carologistics/hardware/TMC2208/Solder_Pads.jpg

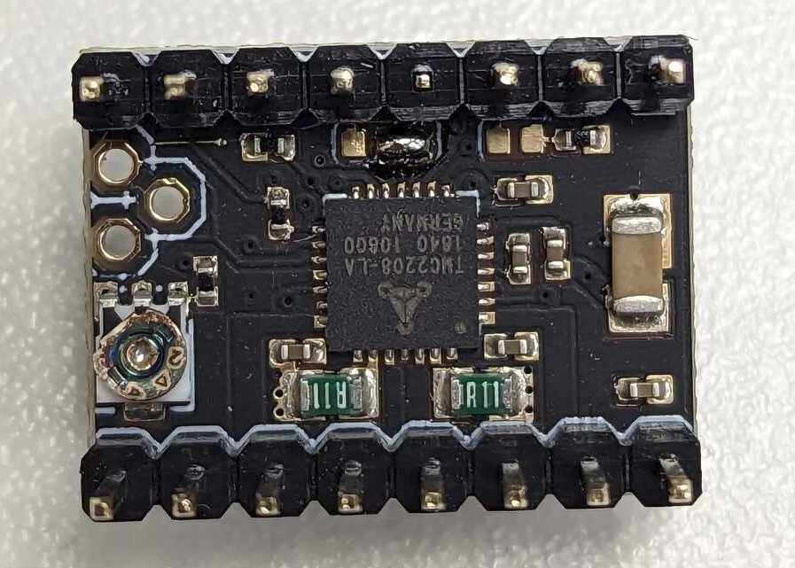
TMC2208/Solder_Pads.jpg
