carologistics/hardware/pictures/frontlaser_mount.jpg

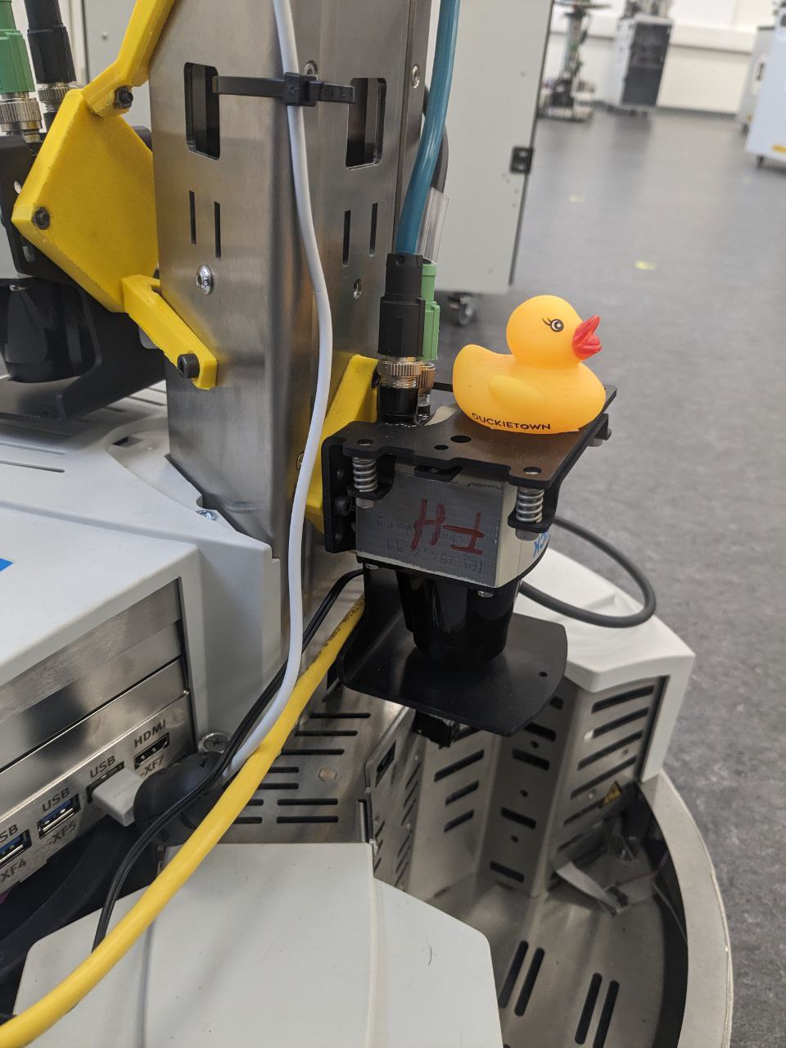
pictures/frontlaser_mount.jpg
