carologistics/hardware/gcode/README.md

# gcode folder

gcode files are needed to start a printjob on a 3d printer.
This folder, and all its subfolders, contain the  gcode files of all the current cad parts.

**NOTE:** Those gcode files are **only** suitable for the Prusa MK3S 3D printer in combination with PLA filament!

## How to start a printjob

1. Copy the gcode file on the printers SD card
2. Insert SD card back into printer
3. Choose file to print
   - If the files do not show up immediatly on the printer, press knob once and scroll down to `print from SD card`
4. Press knob once
5. The print is starting

### Multiple part prints

Some parts have two corresponding gcode files. For those parts, usually, multiple pieces are needed.

For instance, the realsense needs two 3d printed parts to be mounted. They can both be printed with one file.

```
blasterxmounting_x2_0.2mm_PLA_MK3S.gcode
```

However, sometimes only one part is needed. Those single parts can be printed with the file not containing the "x2".

```
blasterxmounting_0.2mm_PLA_MK3S.gcode
```

### Conductive parts

The `backfinger` and the `contact` need to be printed out of conductive PLA.
