carologistics/hardware/Notizen Akku Monitoring/Beschreibung Programm.docx

## Zweck

- Akkuzustand überwachen (Busspannung, Strom, Verbrauch)
- Restlaufzeit grob schätzen (über gemittelten Strom)
- Akkuslots prüfen (Temperatur, Plug in/out, Maschinen-ID)
- Alles nur auf Befehl starten und per Akku-Check abrufen

## Eingänge

### Messwerte

- Gesamtstrom I(t) vom ACS758-200B (A)
- Busspannung U_bus(t) vom Robotino (V)
- Pro Akkuslot:
  - plug_i (0/1) – Akku steckt?
  - temp_i (°C oder Rohwert) – Akkutemperatur
  - id_i (int/Rohwert) – Maschinen-ID

### Parameter (fix / Konfiguration)

- Ah_pack = Kapazität pro Akku (Ah) (alle gleich)
- sample_rate_hz (z. B. 5–10 Hz)
- avg_window_s (z. B. 60 s)
- U0_measure_time_s (z. B. 3 s)

## Ausgänge

### Laufende Statuswerte

- n_packs (Anzahl aktiver Akkus, aus Plug in/out)
- I_last (letzter Stromwert)
- I_avg (Durchschnitt über Zeitfenster)
- Ah_used (verbrauchte Ah seit Start)
- Ah_total = n_packs * Ah_pack
- Ah_rest = Ah_total - Ah_used
- t_rest (Restlaufzeit in h:min)

### Check-Report

- Alles oben + Slotdetails + Zeitstempel der letzten Messung

## Befehle (User Interface)

### 1) /Akku monitorer

Startet Monitoring.

Was passiert:

1. Slots scannen → n_packs bestimmen (aus Plug in/out)
2. Ah_total berechnen
3. U0 setzen:
  - Hinweis im Ablauf: U0 nur bei ruhigen Motorbewegungen
  - Mittelwert über z. B. 3 s
4. Zähler/Buffer zurücksetzen (Ah_used=0, Strompuffer leeren)
5. Monitoring-Loop starten

### 2) /Akku check

Gibt einen Snapshot aus:

- n_packs
- U_bus aktuell + U0 (falls vorhanden)
- I_last + Zeitstempel „letzte Messung“
- I_avg (aktueller Durchschnitt)
- Ah_used / Ah_total
- t_rest
- pro Slot: plug/temp/id

### 3) /Akku stop

Stoppt Monitoring und geht zurück zu Idle.

## Programmzustände

### State A: Idle

- wartet auf /Akku monitorer

### State B: Init

- Akkus erkennen
- U0 aufnehmen (ruhig)
- Variablen initialisieren

### State C: Monitoring

Loop in festem Intervall:

1. Strom messen
- I_last = read_ACS758()
2. Verbrauch integrieren (Coulomb Counting)

Ah_(used) +=I_(last) ⋅(Δt)/3600

3. Durchschnittsstrom aktualisieren
- Puffer mit letzten avg_window_s Sekunden
- I_avg = mean(buffer)
4. Restlaufzeit

t_(rest) =(Ah_(total) -Ah_(used))/(I_(avg))

(Edgecase: wenn I_avg sehr klein → Restlaufzeit als „sehr groß / nicht sinnvoll“)

5. Letzte Messung speichern
- Timestamp aktualisieren
- optional Logging

## Wichtige Hinweise im Programmtext

- U0 nur bei ruhigen Motorbewegungen verwenden, weil Spannung unter Last stark abweicht.
- Robotino liefert Busspannung, keine Einzelakku-Spannungen.
- ACS758 misst Gesamtstrom nach dem Akku-Bus (nicht interne Ausgleichsströme zwischen Akkus).

Akku-Monitoring System Beschreibung Programm
