carologistics/hardware/pictures/backlaser_mount.jpg

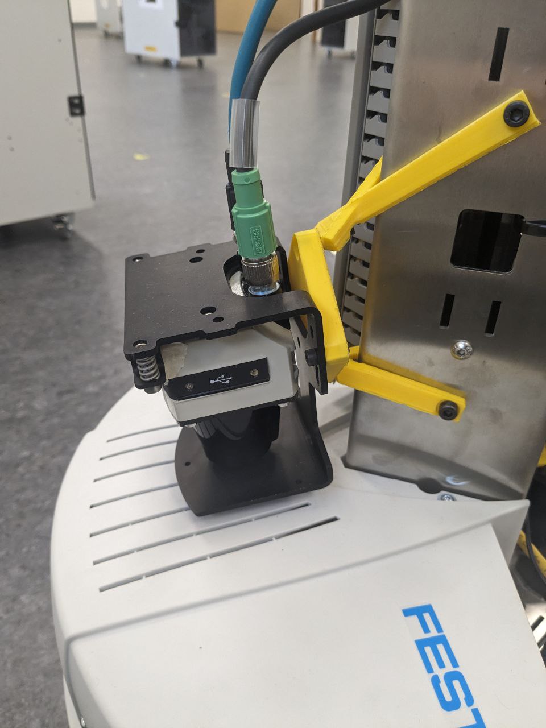
pictures/backlaser_mount.jpg
