carologistics/hardware/cad/realsense/assemblytool.SLDPRT

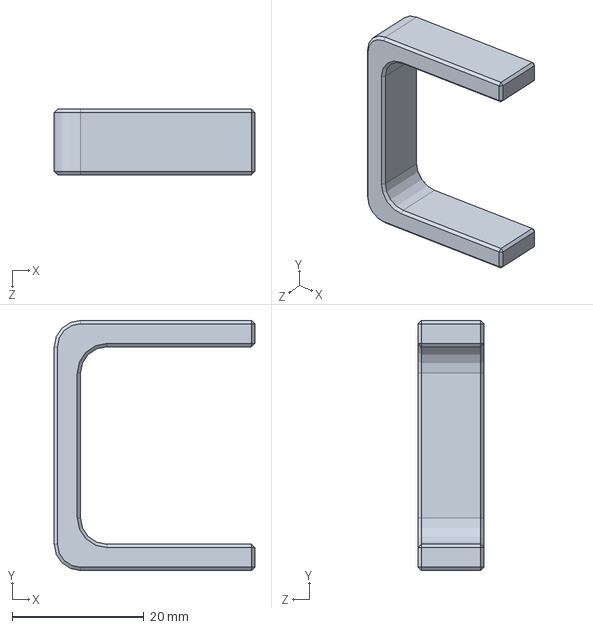
[picture p4: CAD file, 2019-02-01]
cad/realsense/assemblytool.SLDPRT
30.5 x 38.0 x 10.0 mm
