carologistics/hardware/cad/gripper/assembled_positioningdisk.SLDASM

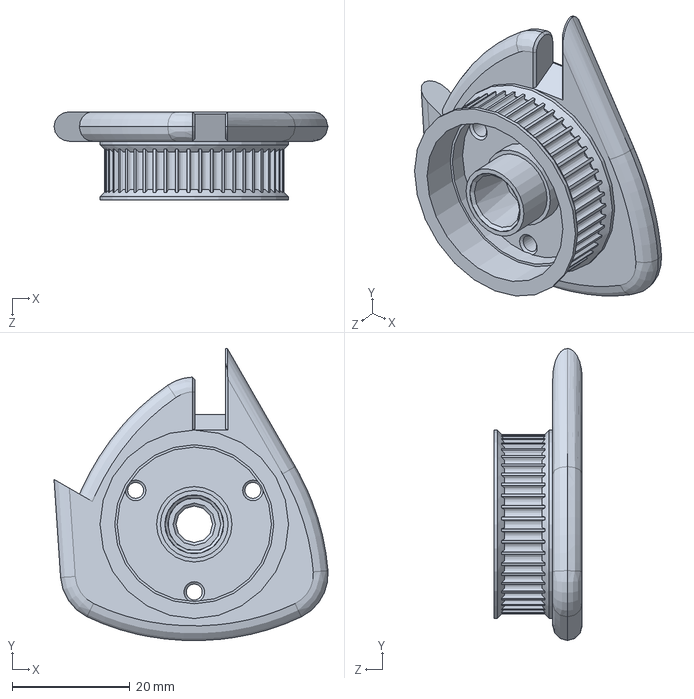
[picture p5: CAD file, 2024-03-26]
cad/gripper/assembled_positioningdisk.SLDASM
46.5 x 49.6 x 15.0 mm
