carologistics/hardware/cad/gripper/baseplatejoined.SLDASM

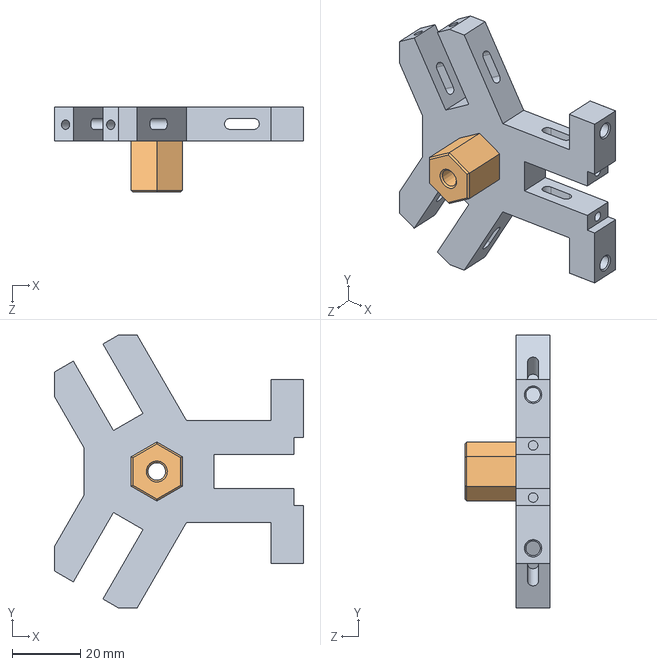
[picture p6: CAD file, 2024-03-26]
cad/gripper/baseplatejoined.SLDASM
73.0 x 80.0 x 25.0 mm
baseplate
middleconnector
