carologistics/hardware/cad/gripper/gripperassembly.SLDASM

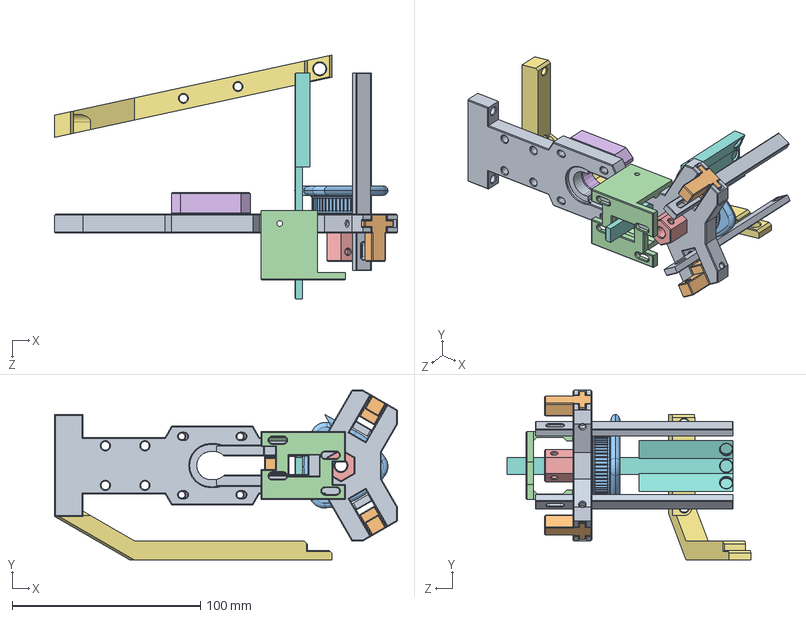
[picture p7: CAD file, 2019-10-24]
cad/gripper/gripperassembly.SLDASM
182.0 x 90.0 x 129.4 mm
baseplate
stopper x 3
positioningdisk
middleconnector
stepperflange
backfinger
frontfinger x 2
