carologistics/hardware/cad/axes/yaxismounting.SLDPRT

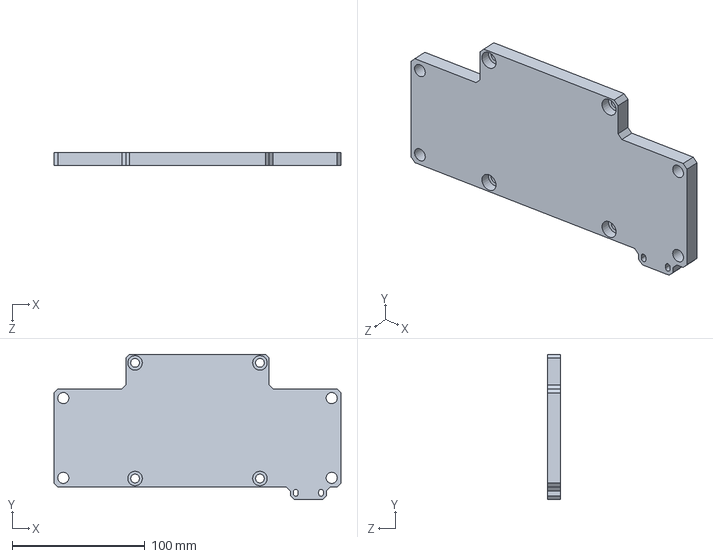
[picture p8: CAD file, 2024-03-26]
cad/axes/yaxismounting.SLDPRT
216.0 x 109.5 x 10.0 mm
