carologistics/hardware/cad/gripper/Gripper Version 2 (speziell deutsche Meisterschaft)/stl/01-01 Gripper_Basis_2 Servo System.stl

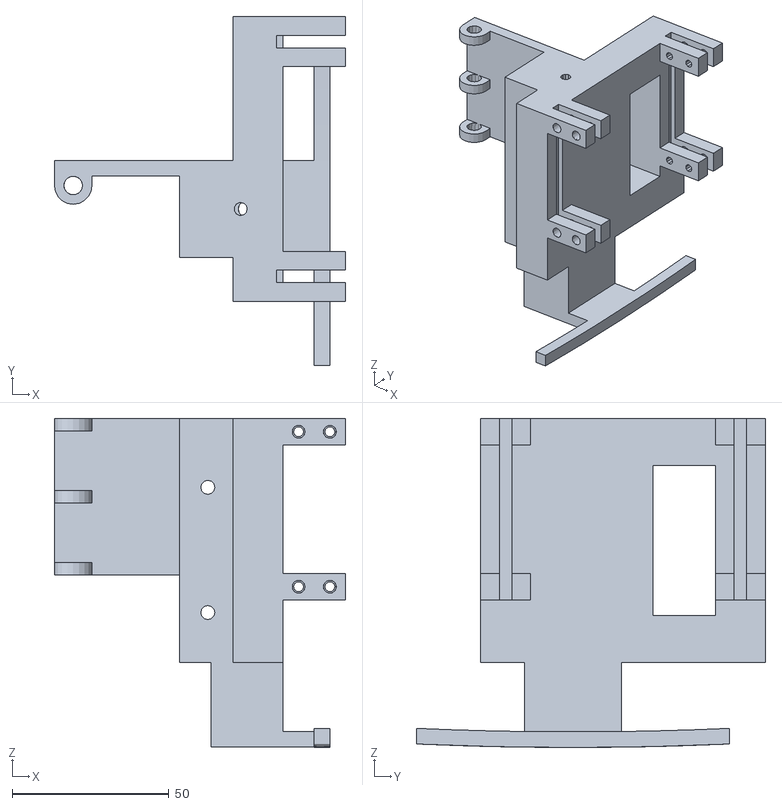
[picture p9: CAD file, 2026-03-07]
cad/gripper/Gripper Version 2 (speziell deutsche Meisterschaft)/stl/01-01 Gripper_Basis_2 Servo System.stl
93.0 x 111.5 x 105.1
