carologistics/hardware/cad/gripper/Gripper Version 2/stl/01-03-02-01 Zeichnung Zange rechts.stl

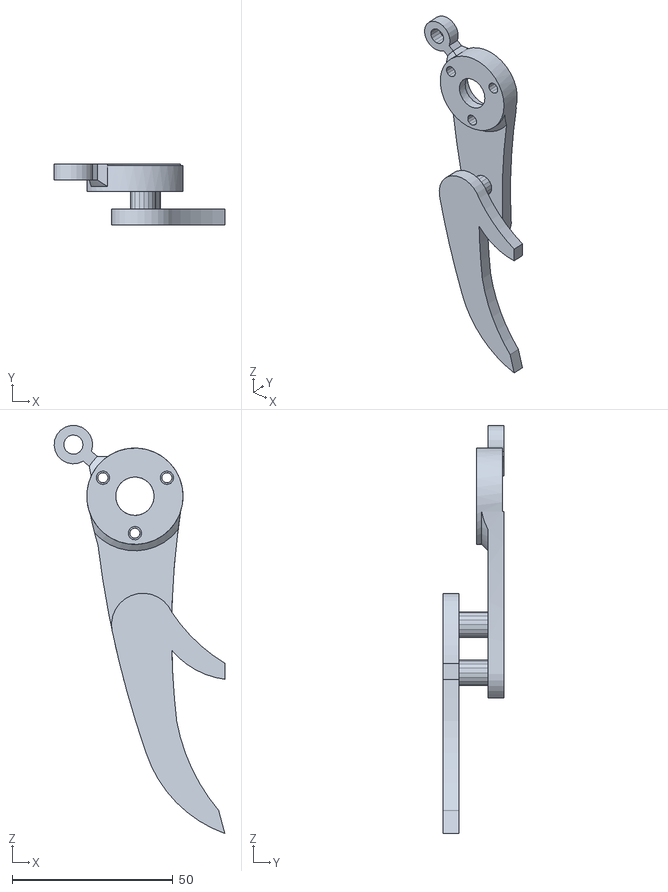
[picture p10: CAD file, 2026-03-07]
cad/gripper/Gripper Version 2/stl/01-03-02-01 Zeichnung Zange rechts.stl
53.1 x 19.0 x 127.0
