carologistics/hardware/cad/gripper/motormount.SLDPRT

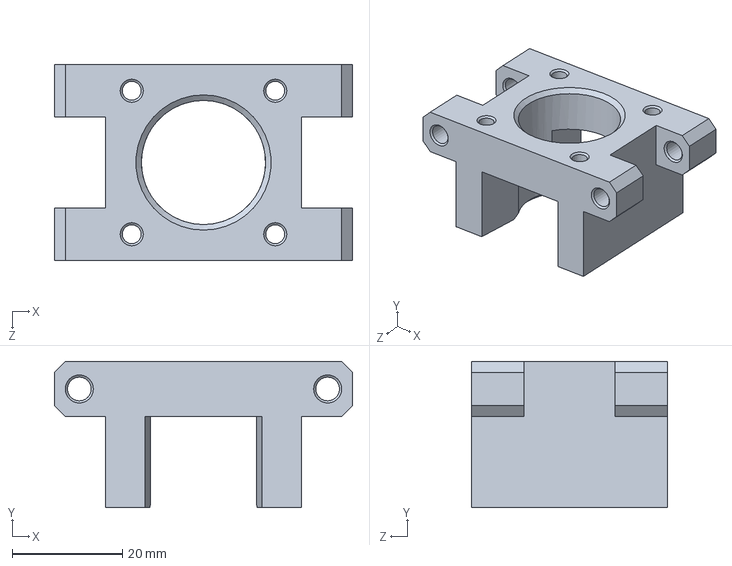
[picture p11: CAD file, 2024-03-26]
cad/gripper/motormount.SLDPRT
54.0 x 26.5 x 35.5 mm
