carologistics/hardware/cad/gripper/stl/gripperflange_support.STL

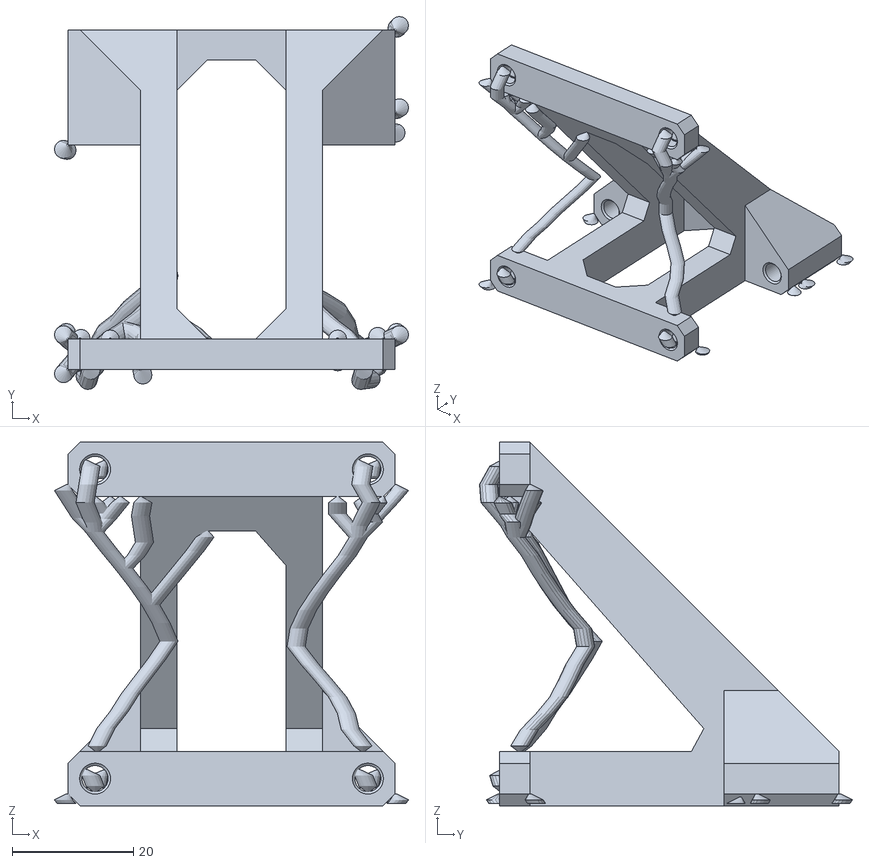
[picture p12: CAD file, 2024-03-26]
cad/gripper/stl/gripperflange_support.STL
58.4 x 61.5 x 60.0
