carologistics/hardware/cad/laser/adapterplate.SLDPRT

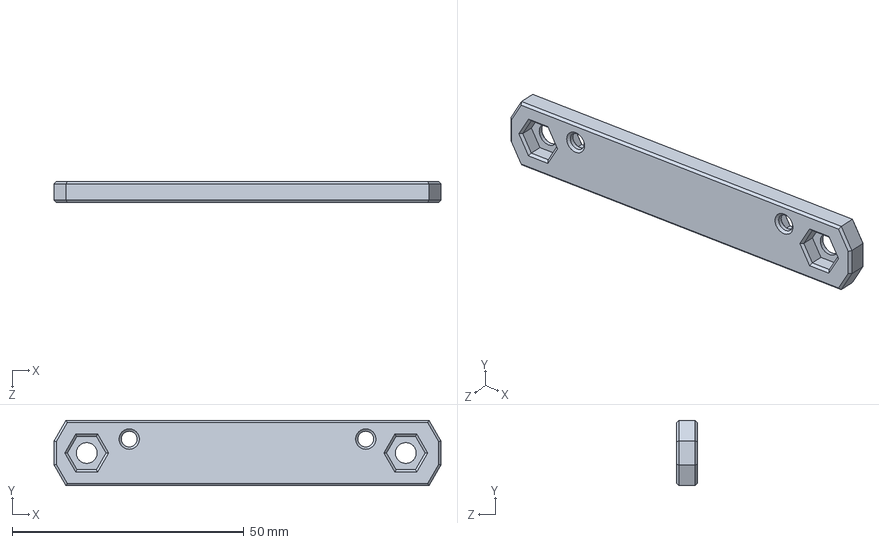
[picture p13: CAD file, 2019-01-17]
cad/laser/adapterplate.SLDPRT
83.4 x 14.1 x 4.50 mm
