carologistics/hardware/cad/norm_parts/threadedrod_m4x170.SLDPRT

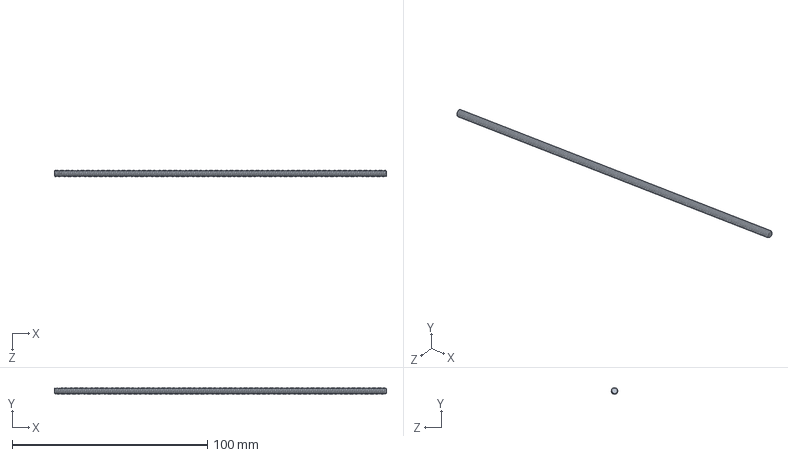
[picture p14: CAD file, 2024-03-26]
cad/norm_parts/threadedrod_m4x170.SLDPRT
170.0 x 3.36 x 3.36 mm
