carologistics/hardware/cad/realsense/blasterxmounting.SLDPRT

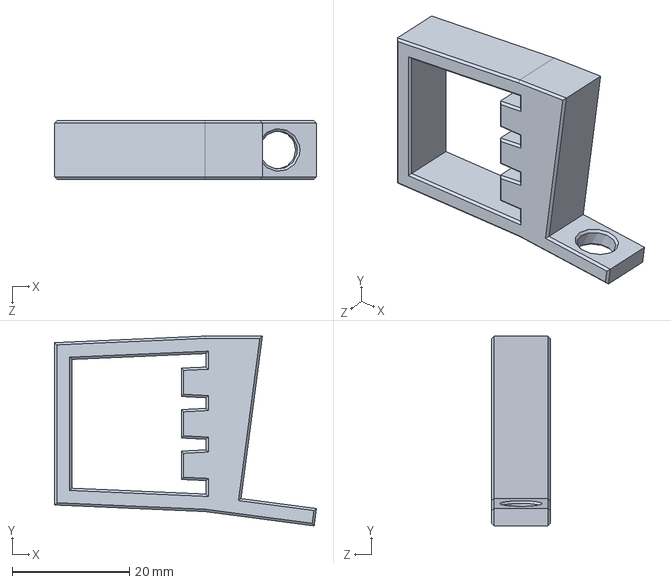
[picture p15: CAD file, 2024-03-26]
cad/realsense/blasterxmounting.SLDPRT
44.8 x 32.4 x 10.0 mm
