carologistics/hardware/cad/realsense2/sliderjoint_rs2.SLDPRT

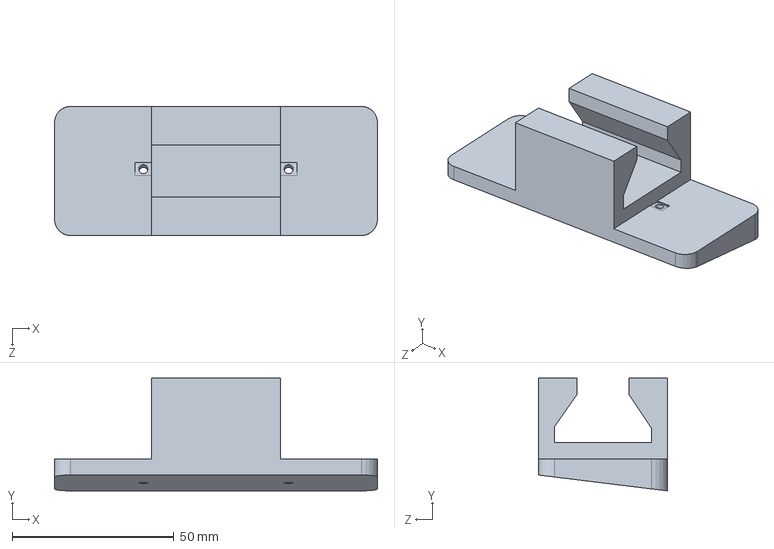
[picture p16: CAD file, 2024-03-26]
cad/realsense2/sliderjoint_rs2.SLDPRT
100.0 x 34.9 x 40.0 mm
