carologistics/hardware/cad/robotino/frontlasermounting.SLDPRT

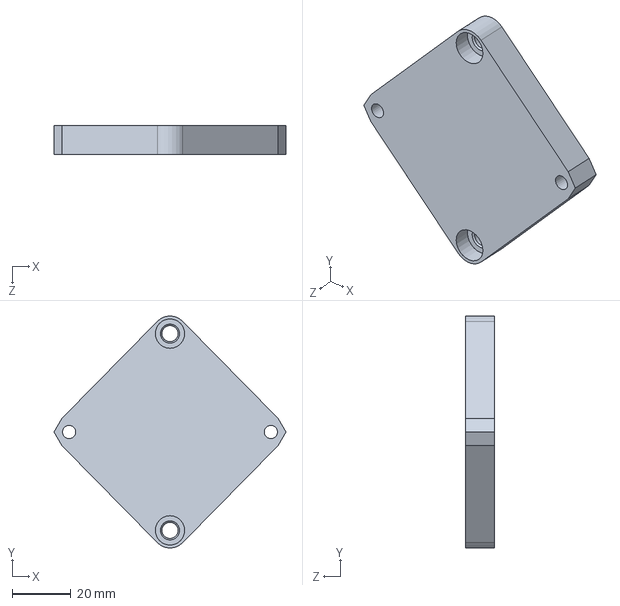
[picture p17: CAD file, 2024-03-26]
cad/robotino/frontlasermounting.SLDPRT
79.0 x 78.9 x 10.0 mm
