carologistics/hardware/cad/axes/uno_carrier.SLDPRT

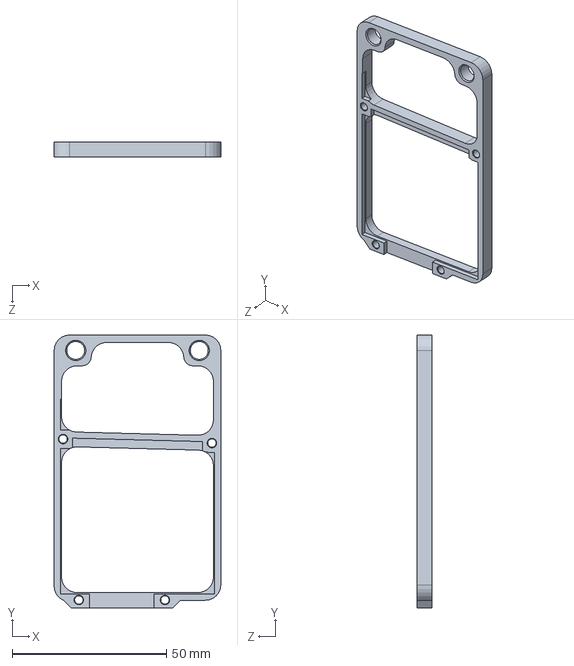
[picture p18: CAD file, 2024-03-26]
cad/axes/uno_carrier.SLDPRT
54.0 x 88.4 x 5.00 mm
