carologistics/hardware/cad/gripper/backfinger.SLDPRT

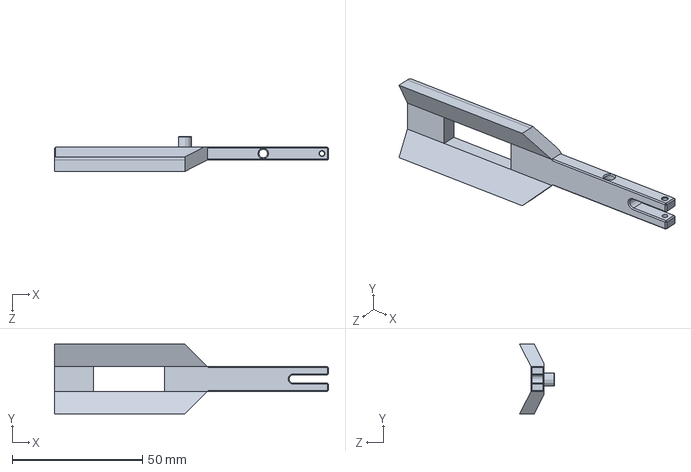
[picture p19: CAD file, 2024-03-26]
cad/gripper/backfinger.SLDPRT
105.0 x 26.7 x 13.4 mm
