carologistics/hardware/cad/gripper/Gripper Version 2 (speziell deutsche Meisterschaft)/stl/01-02-02 Gripper neu.stl

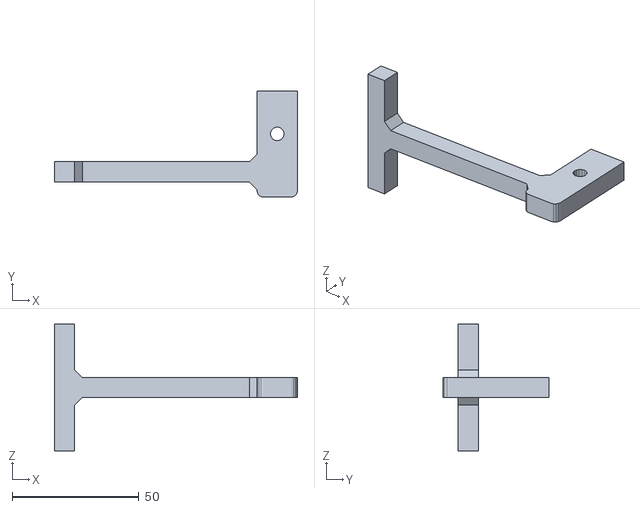
[picture p20: CAD file, 2026-03-07]
cad/gripper/Gripper Version 2 (speziell deutsche Meisterschaft)/stl/01-02-02 Gripper neu.stl
96.0 x 42.0 x 50.0
