carologistics/hardware/cad/gripper/Gripper Version 2/stl/01-01 Gripper_Basis_2 Servo System.stl

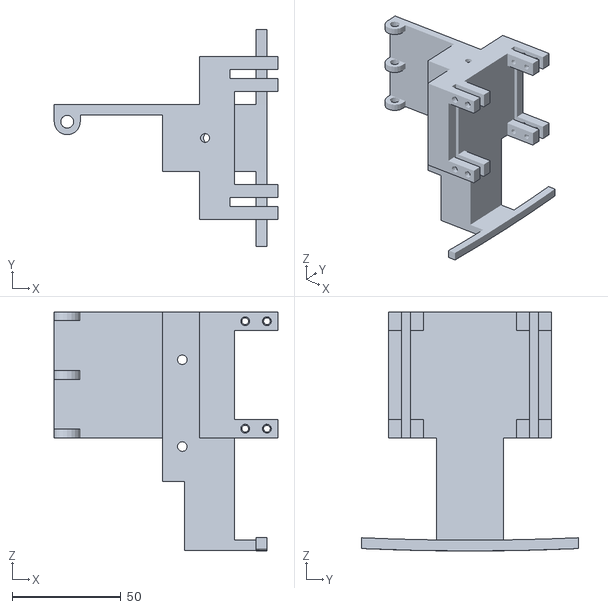
[picture p21: CAD file, 2026-03-07]
cad/gripper/Gripper Version 2/stl/01-01 Gripper_Basis_2 Servo System.stl
103.0 x 100.0 x 110.1
