carologistics/hardware/cad/norm_parts/hexnut_m6_iso4032.SLDPRT

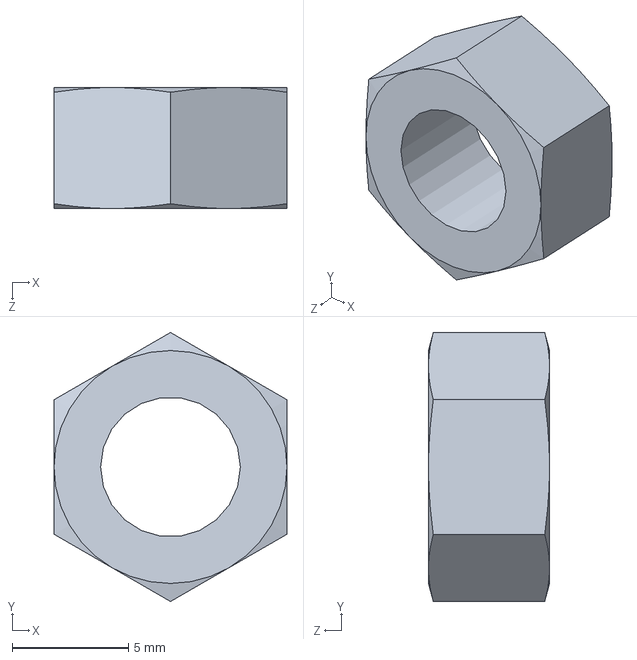
[picture p22: CAD file, 2024-03-26]
cad/norm_parts/hexnut_m6_iso4032.SLDPRT
10.0 x 11.5 x 5.20 mm
