carologistics/hardware/cad/realsense/positioningclamp.SLDPRT

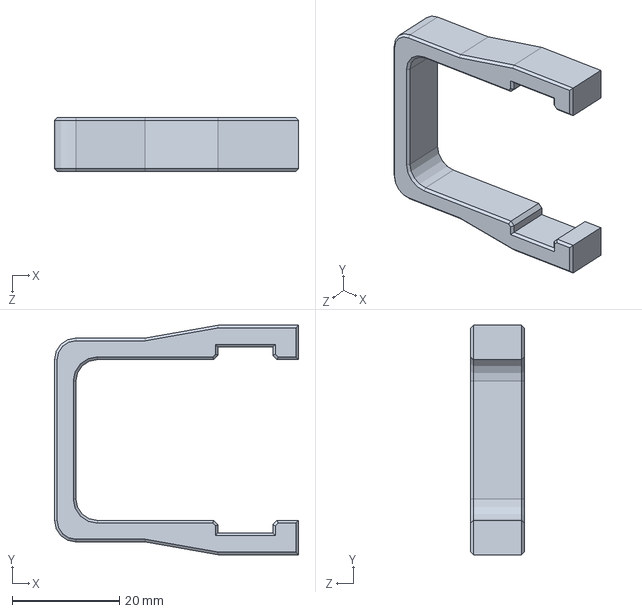
[picture p23: CAD file, 2019-04-29]
cad/realsense/positioningclamp.SLDPRT
45.5 x 42.8 x 10.0 mm
