carologistics/hardware/cad/realsense2/base_rs2.SLDPRT

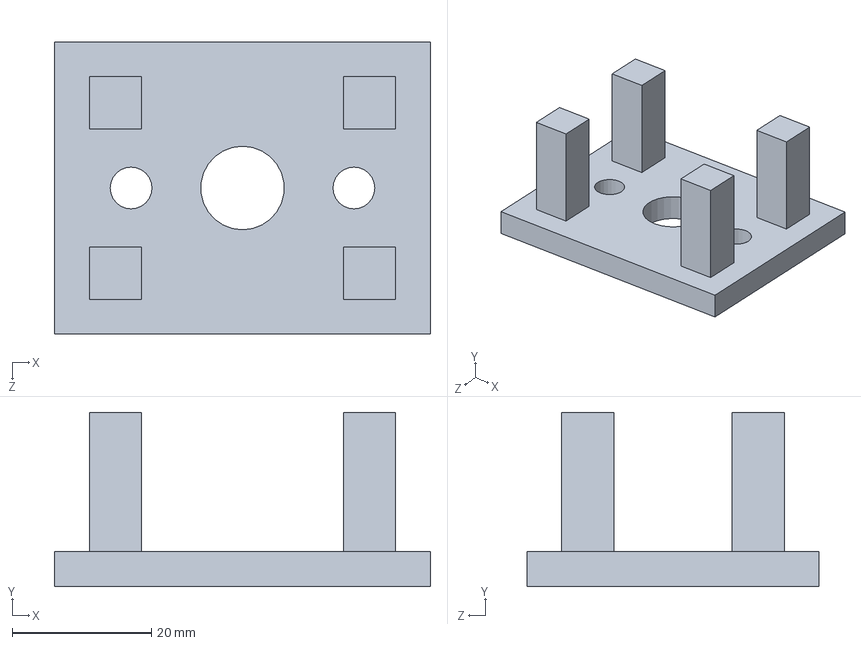
[picture p24: CAD file, 2024-03-26]
cad/realsense2/base_rs2.SLDPRT
54.0 x 25.0 x 42.0 mm
