carologistics/hardware/cad/robotino/APmount.SLDPRT

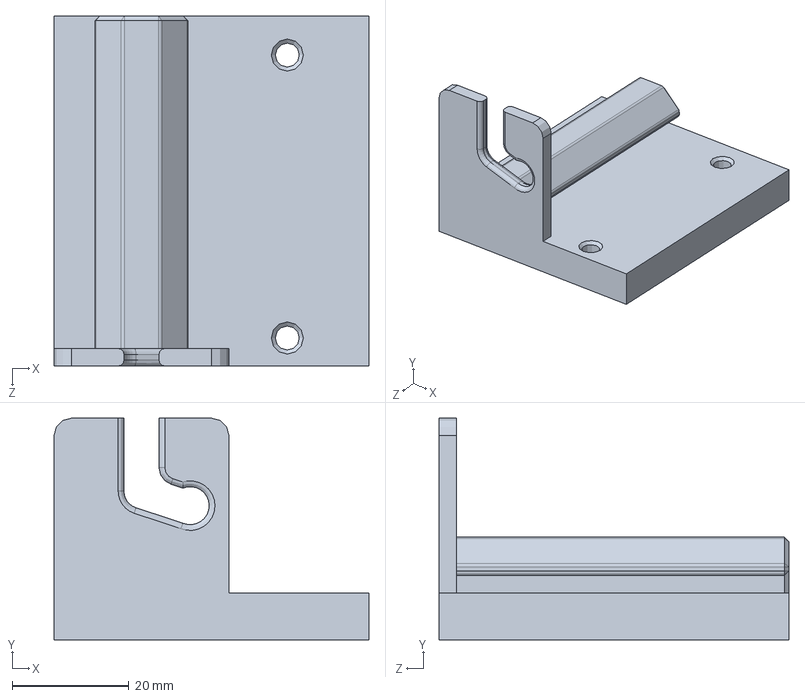
[picture p25: CAD file, 2024-03-26]
cad/robotino/APmount.SLDPRT
54.0 x 38.0 x 60.0 mm
