carologistics/hardware/cad/axes/zaxismounting.SLDPRT

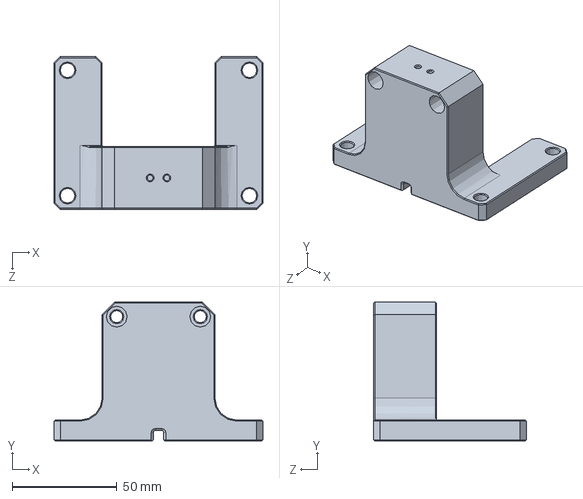
[picture p26: CAD file, 2024-03-26]
cad/axes/zaxismounting.SLDPRT
100.0 x 66.5 x 73.0 mm
