carologistics/hardware/cad/gripper/frontfinger.SLDPRT

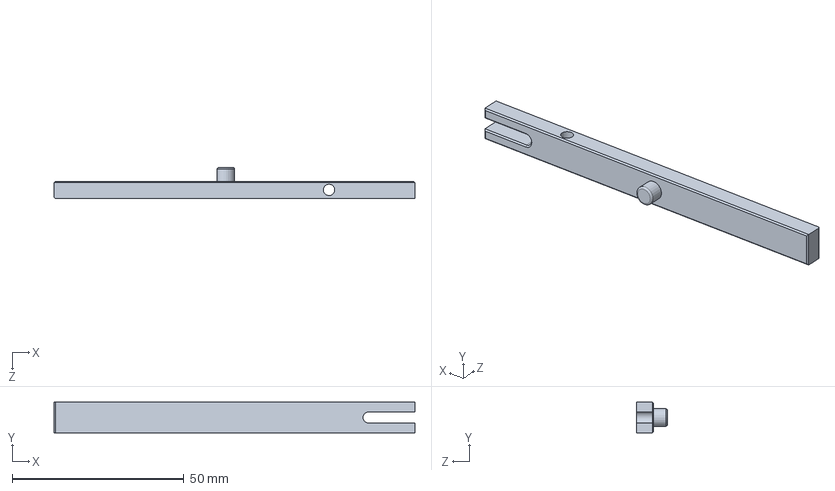
[picture p27: CAD file, 2024-03-26]
cad/gripper/frontfinger.SLDPRT
105.0 x 9.00 x 9.00 mm
