carologistics/hardware/cad/gripper/Gripper Version 2 (speziell deutsche Meisterschaft)/stl/01-05 Absicherung Richtung Kugellager.stl

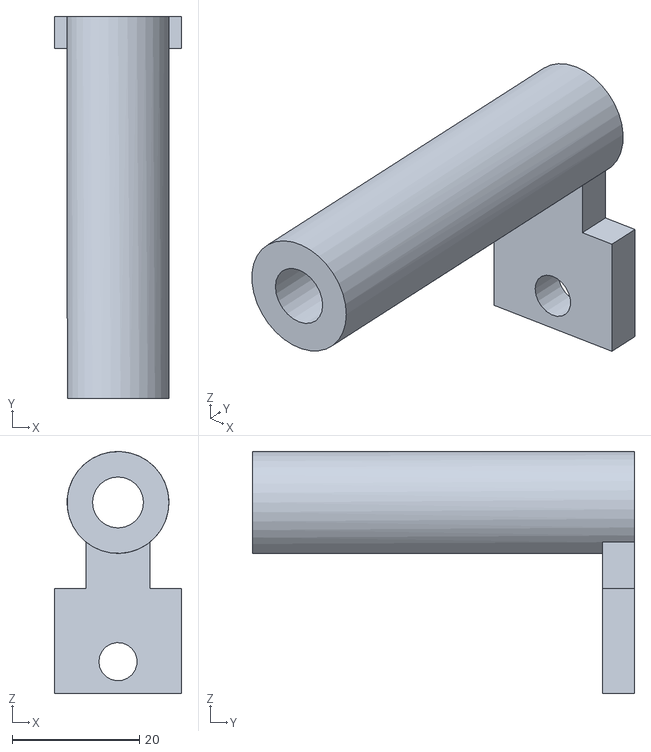
[picture p28: CAD file, 2026-03-03]
cad/gripper/Gripper Version 2 (speziell deutsche Meisterschaft)/stl/01-05 Absicherung Richtung Kugellager.stl
20.0 x 60.0 x 38.0
