carologistics/hardware/cad/realsense/rsmounting.SLDPRT

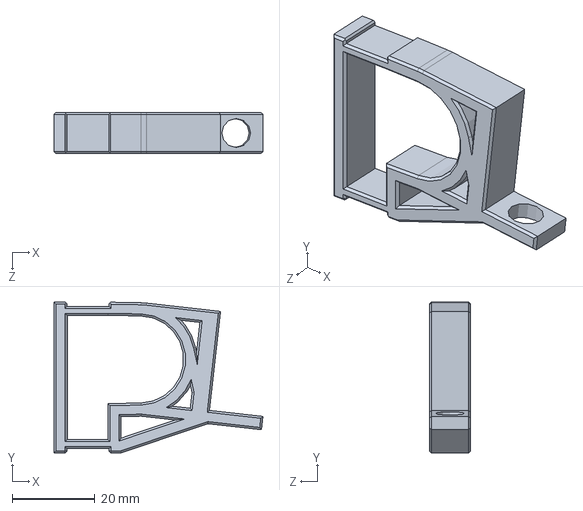
[picture p29: CAD file, 2019-04-29]
cad/realsense/rsmounting.SLDPRT
50.5 x 36.4 x 10.0 mm
