carologistics/hardware/cad/realsense2/mountflange_rs2.SLDPRT

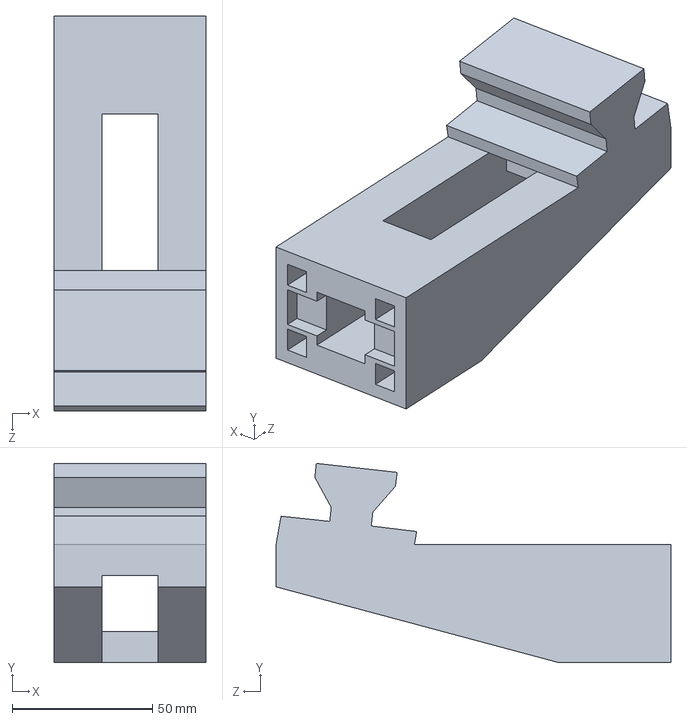
[picture p30: CAD file, 2024-03-26]
cad/realsense2/mountflange_rs2.SLDPRT
54.0 x 71.0 x 140.8 mm
