carologistics/hardware/cad/robotino/switchmount.SLDPRT

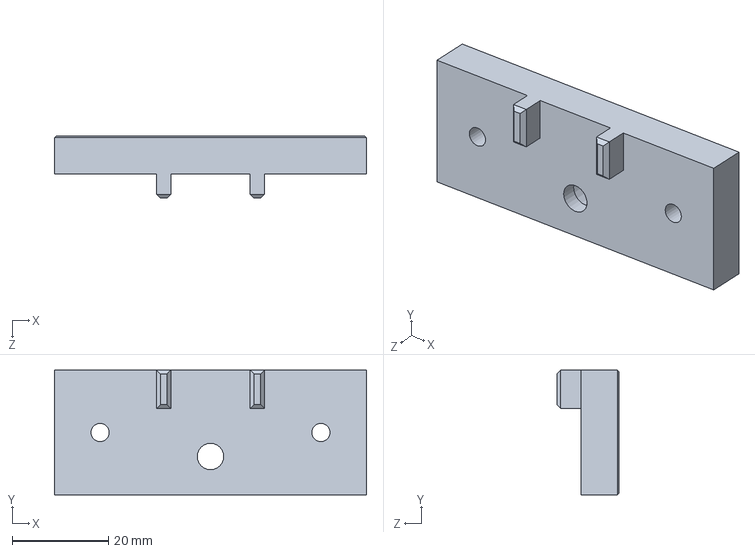
[picture p31: CAD file, 2019-06-25]
cad/robotino/switchmount.SLDPRT
65.0 x 26.0 x 13.0 mm
