carologistics/hardware/cad/axes/tablecablechainmounting.SLDPRT

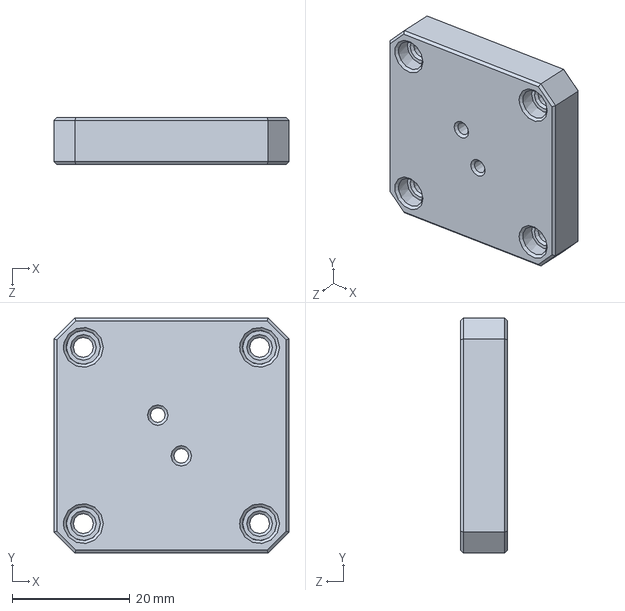
[picture p32: CAD file, 2024-03-26]
cad/axes/tablecablechainmounting.SLDPRT
40.0 x 40.0 x 8.00 mm
