carologistics/hardware/cad/gripper/frontspacer.SLDPRT

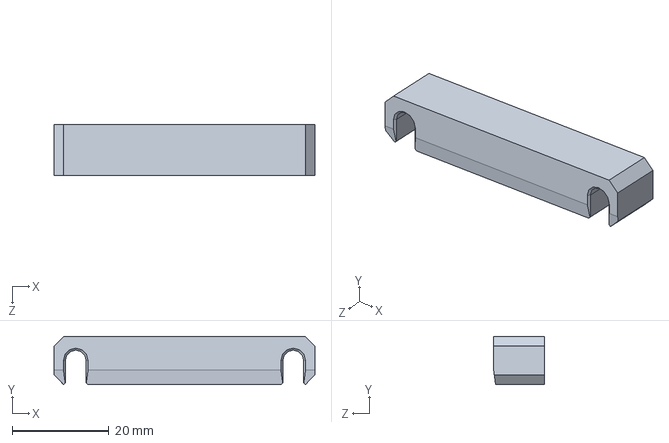
[picture p33: CAD file, 2024-03-26]
cad/gripper/frontspacer.SLDPRT
54.0 x 10.0 x 10.5 mm
