carologistics/hardware/cad/gripper/Gripper Version 2 (speziell deutsche Meisterschaft)/stl/01-03-01-02 Zeichnung Zange links oben.stl

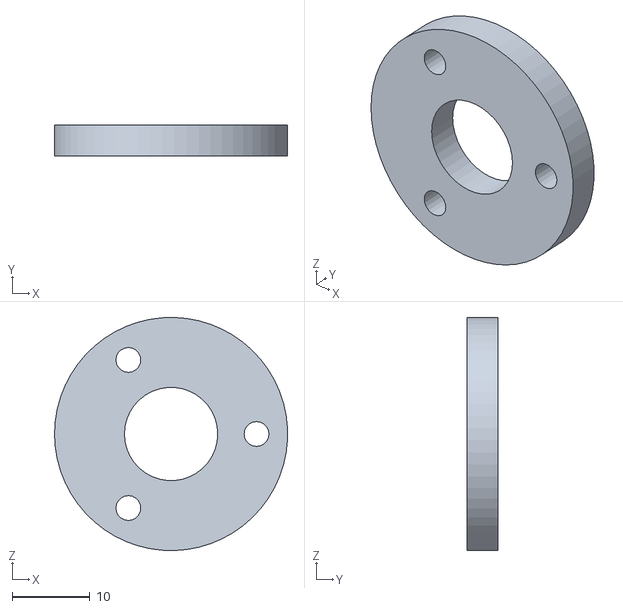
[picture p34: CAD file, 2026-03-03]
cad/gripper/Gripper Version 2 (speziell deutsche Meisterschaft)/stl/01-03-01-02 Zeichnung Zange links oben.stl
30.0 x 4.00 x 30.0
