carologistics/hardware/cad/gripper/Gripper Version 2/stl/01-03-01-01 Zeichnung Zange links unten.stl

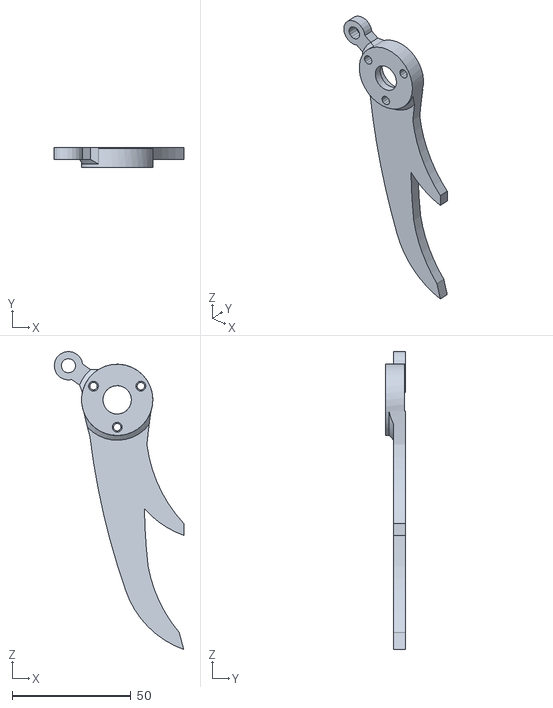
[picture p35: CAD file, 2026-03-07]
cad/gripper/Gripper Version 2/stl/01-03-01-01 Zeichnung Zange links unten.stl
54.5 x 8.50 x 125.3
