carologistics/hardware/cad/robotino/backlaserbottom.SLDPRT

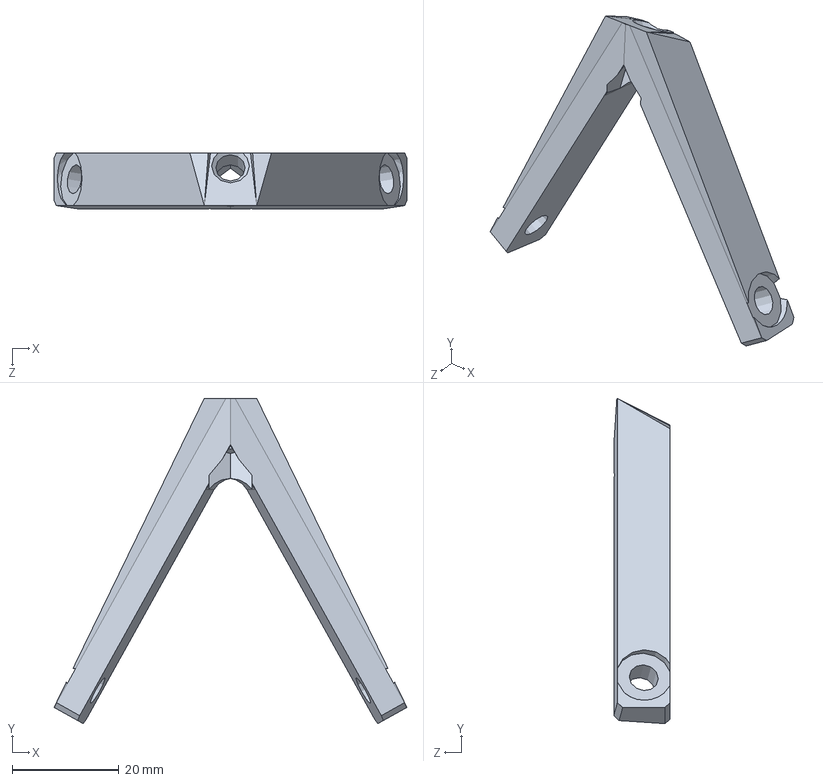
[picture p36: CAD file, 2019-05-02]
cad/robotino/backlaserbottom.SLDPRT
66.2 x 61.0 x 10.6 mm
