carologistics/hardware/cad/axes/yaxiscablechainmounting.SLDPRT

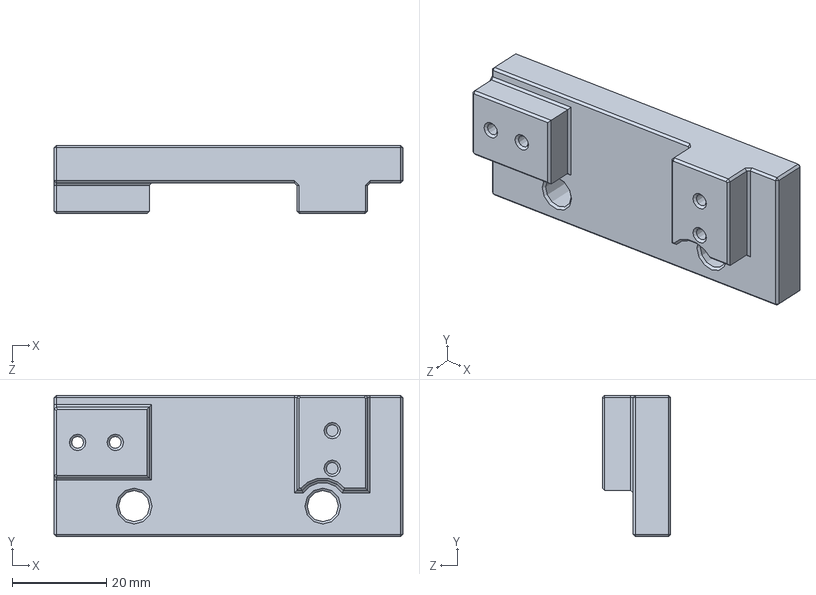
[picture p37: CAD file, 2019-03-21]
cad/axes/yaxiscablechainmounting.SLDPRT
74.0 x 30.0 x 14.5 mm
