carologistics/hardware/cad/gripper/supportprong.SLDPRT

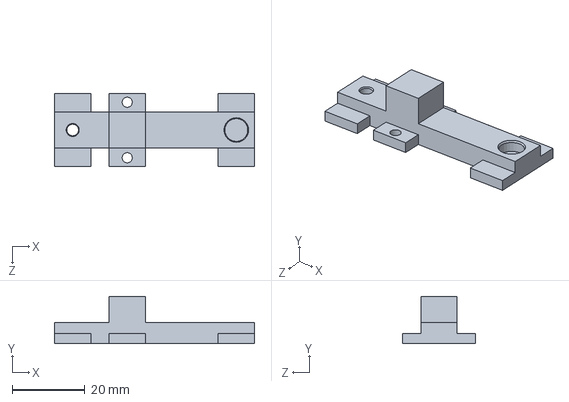
[picture p38: CAD file, 2024-03-26]
cad/gripper/supportprong.SLDPRT
55.0 x 13.0 x 20.0 mm
