carologistics/hardware/cad/realsense/d435mount.SLDPRT

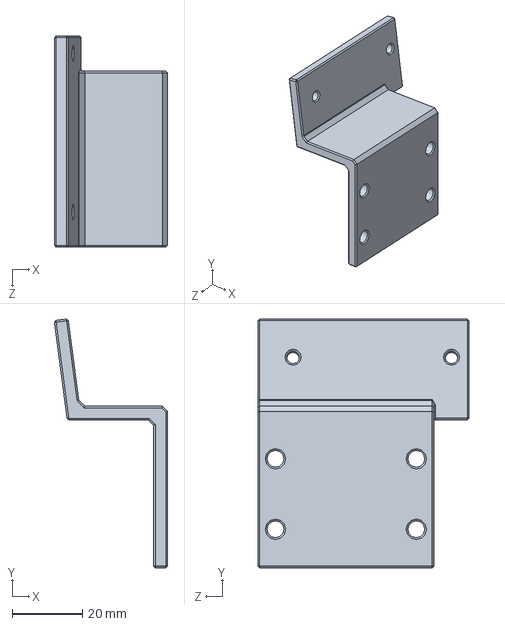
[picture p39: CAD file, 2019-01-18]
cad/realsense/d435mount.SLDPRT
32.2 x 70.7 x 60.0 mm
