carologistics/hardware/cad/robotino/backlasertop.SLDPRT

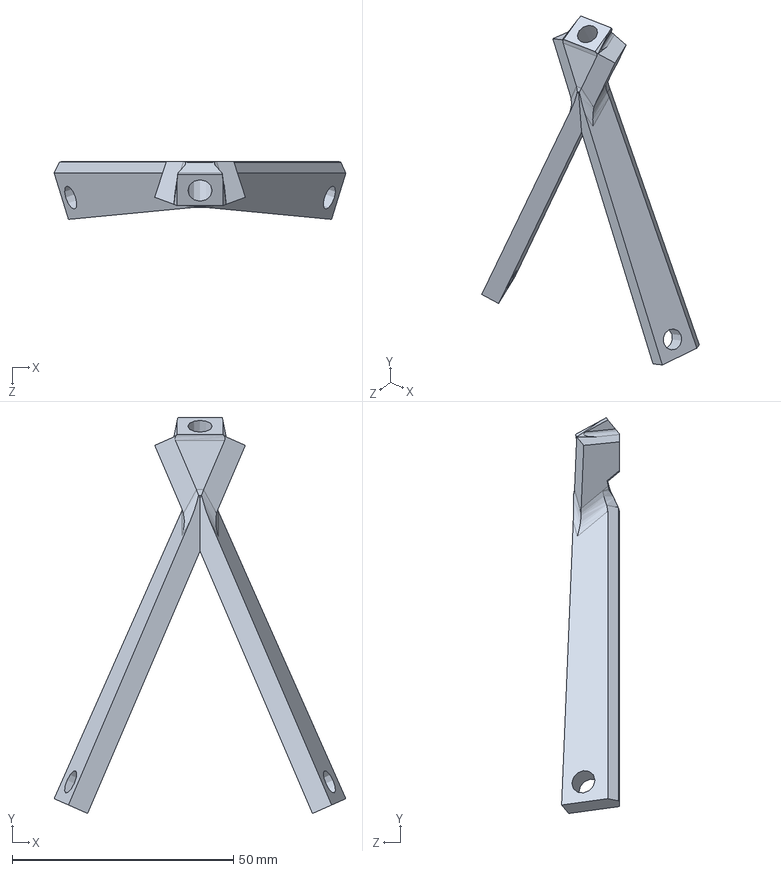
[picture p40: CAD file, 2019-05-01]
cad/robotino/backlasertop.SLDPRT
66.0 x 89.5 x 13.1 mm
