carologistics/hardware/cad/axes/xaxisendstopmounting.SLDPRT

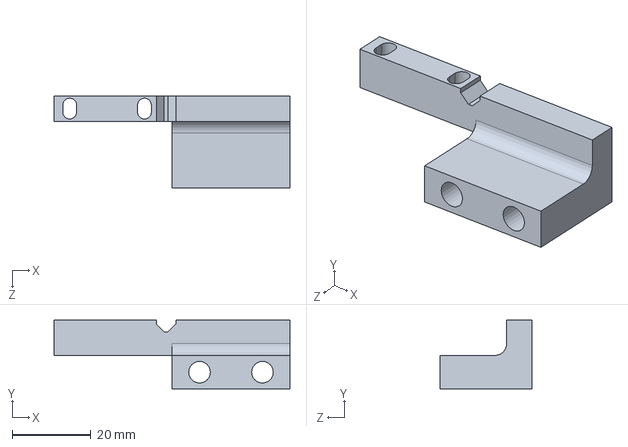
[picture p41: CAD file, 2018-12-05]
cad/axes/xaxisendstopmounting.SLDPRT
60.0 x 17.5 x 23.5 mm
