carologistics/hardware/cad/norm_parts/Nema14.SLDPRT

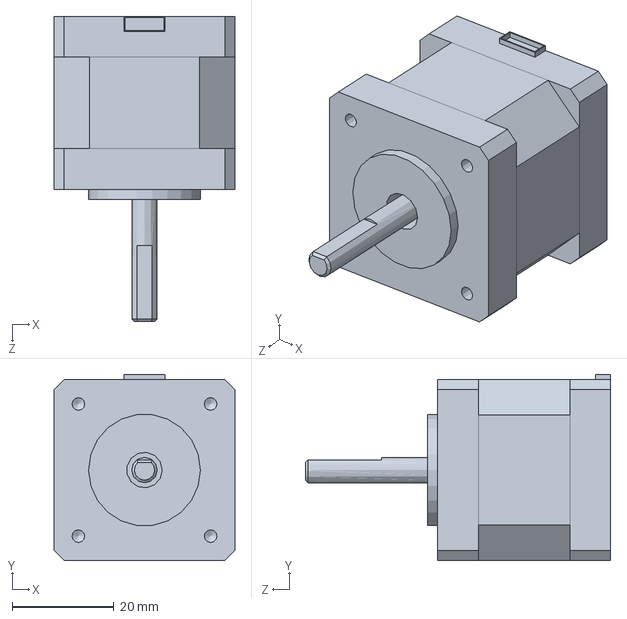
[picture p42: CAD file, 2024-03-26]
cad/norm_parts/Nema14.SLDPRT
35.6 x 36.6 x 60.0 mm
