carologistics/hardware/cad/realsense/circuithousing.SLDPRT

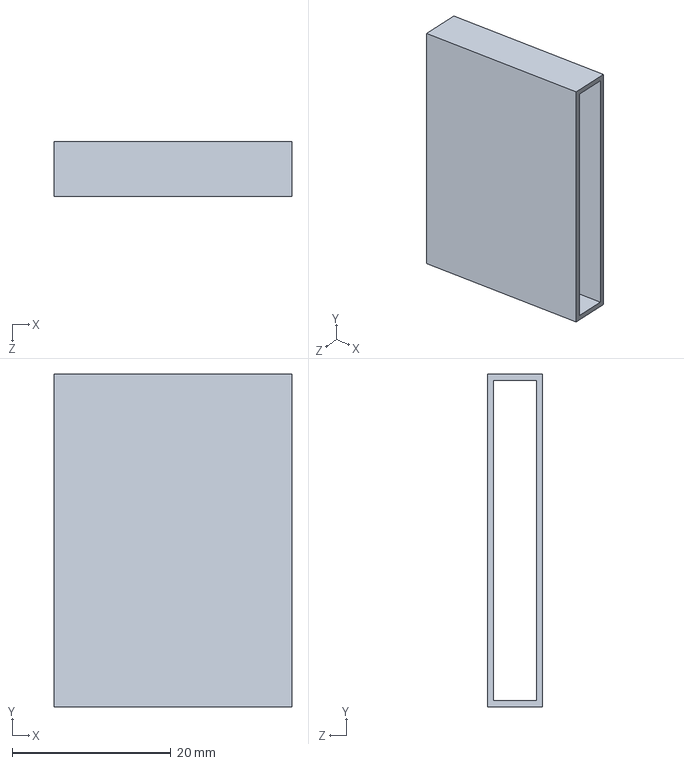
[picture p43: CAD file, 2019-01-17]
cad/realsense/circuithousing.SLDPRT
30.0 x 42.0 x 7.00 mm
