carologistics/hardware/cad/robotino/pcmountlaptop.SLDPRT

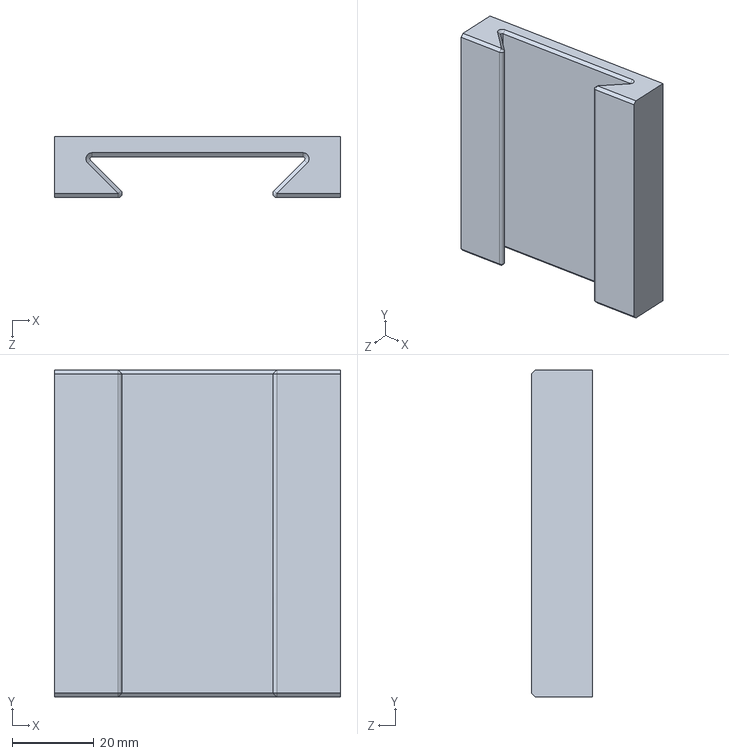
[picture p44: CAD file, 2019-04-13]
cad/robotino/pcmountlaptop.SLDPRT
70.0 x 80.0 x 15.0 mm
