carologistics/hardware/cad/axes/zaxisendstopmounting.SLDPRT

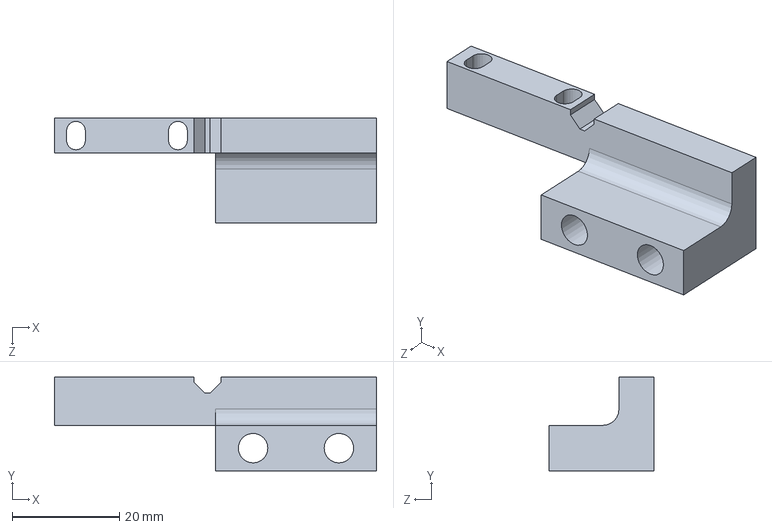
[picture p45: CAD file, 2018-12-05]
cad/axes/zaxisendstopmounting.SLDPRT
60.0 x 17.5 x 19.5 mm
