carologistics/hardware/cad/gripper/endstopmount.SLDPRT

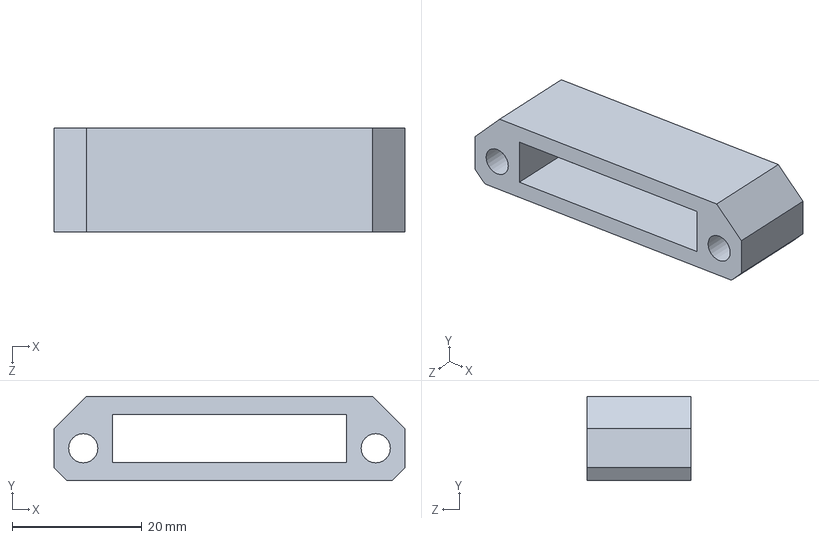
[picture p46: CAD file, 2024-03-26]
cad/gripper/endstopmount.SLDPRT
54.0 x 13.0 x 16.0 mm
