carologistics/hardware/cad/norm_parts/hexnut_m4_iso4032.SLDPRT

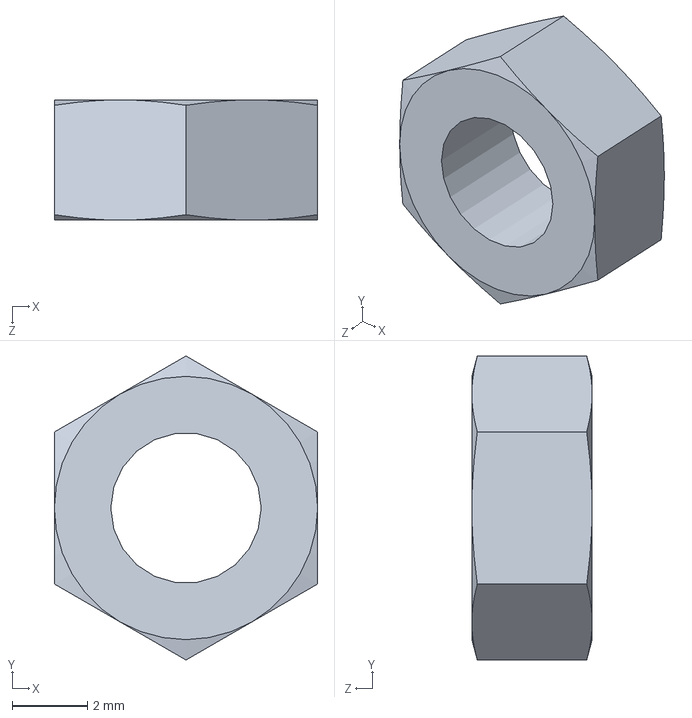
[picture p47: CAD file, 2024-03-26]
cad/norm_parts/hexnut_m4_iso4032.SLDPRT
7.00 x 8.08 x 3.20 mm
