carologistics/hardware/cad/realsense/mountingadapter.SLDPRT

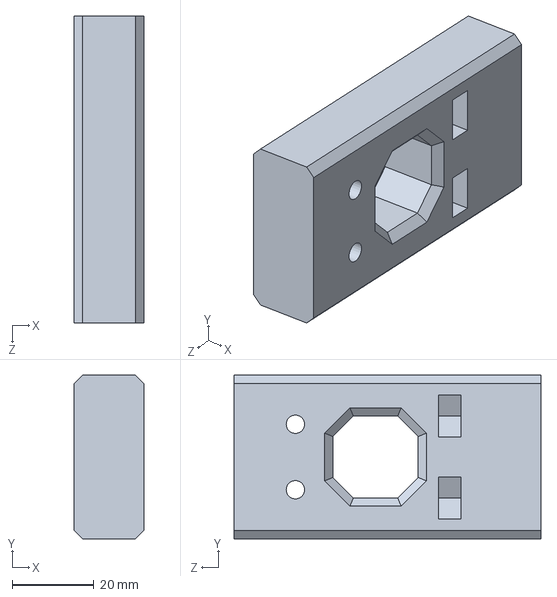
[picture p48: CAD file, 2018-12-05]
cad/realsense/mountingadapter.SLDPRT
17.0 x 40.0 x 75.0 mm
