carologistics/hardware/cad/robotino/pcmountbot.SLDPRT

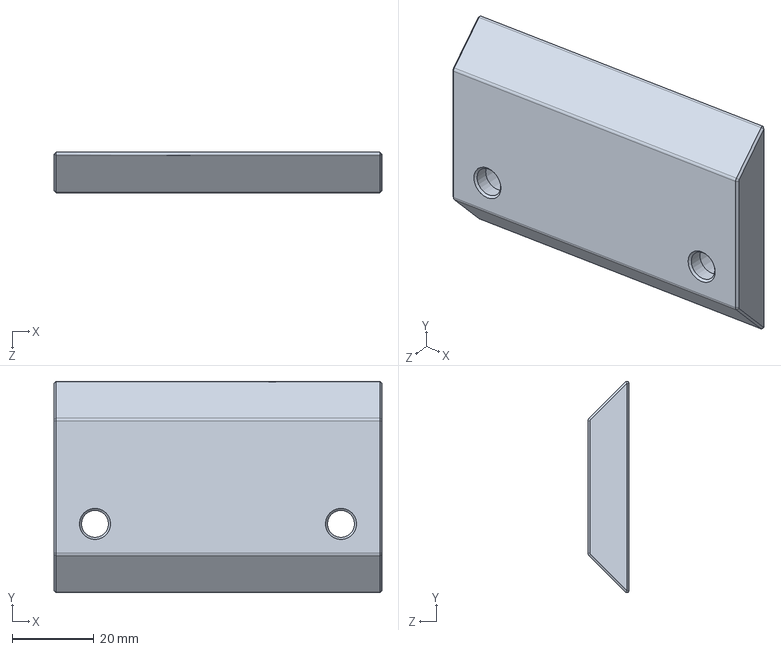
[picture p49: CAD file, 2019-04-13]
cad/robotino/pcmountbot.SLDPRT
80.0 x 51.6 x 10.0 mm
