carologistics/hardware/cad/gripper/baseplate.SLDPRT

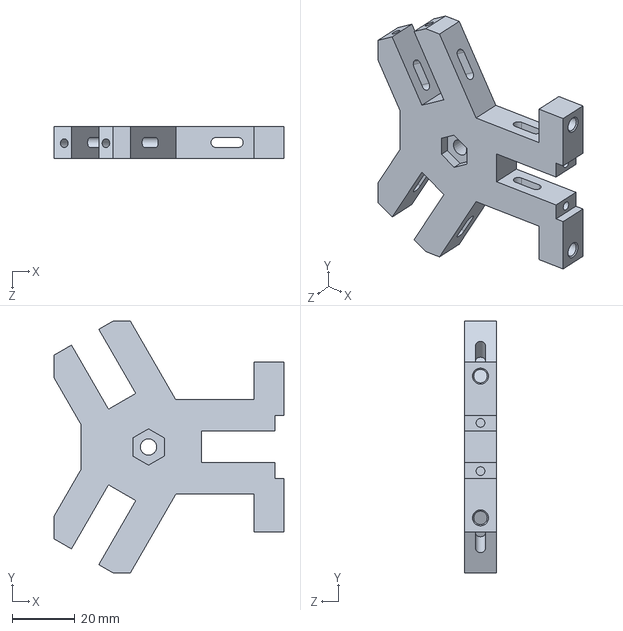
[picture p50: CAD file, 2024-03-26]
cad/gripper/baseplate.SLDPRT
73.0 x 80.0 x 10.0 mm
