carologistics/hardware/cad/norm_parts/parallelpin_3x30_iso_2338.SLDPRT

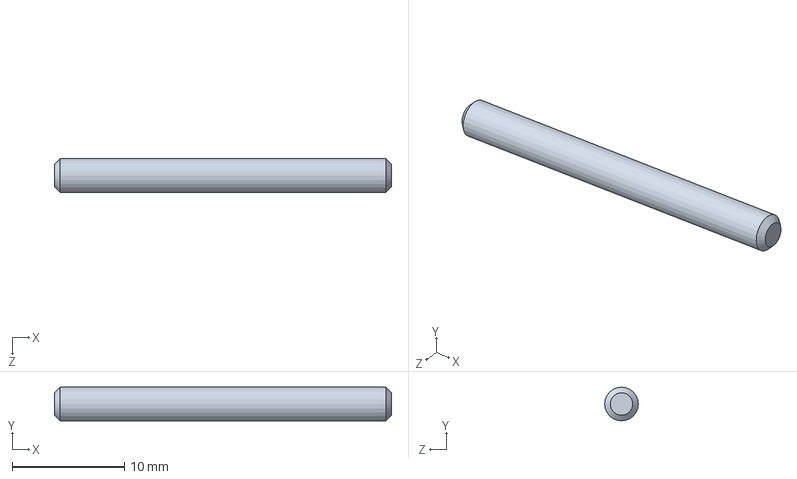
[picture p51: CAD file, 2024-03-26]
cad/norm_parts/parallelpin_3x30_iso_2338.SLDPRT
30.0 x 3.00 x 3.00 mm
