carologistics/hardware/cad/robotino/tagcameramounting.SLDPRT

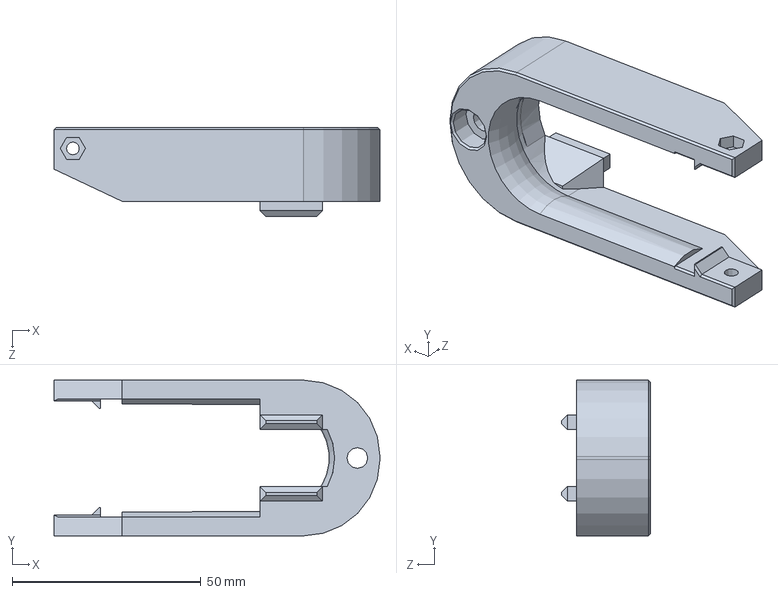
[picture p52: CAD file, 2019-02-22]
cad/robotino/tagcameramounting.SLDPRT
86.4 x 41.2 x 23.5 mm
