carologistics/hardware/cad/gripper/middleconnector.SLDPRT

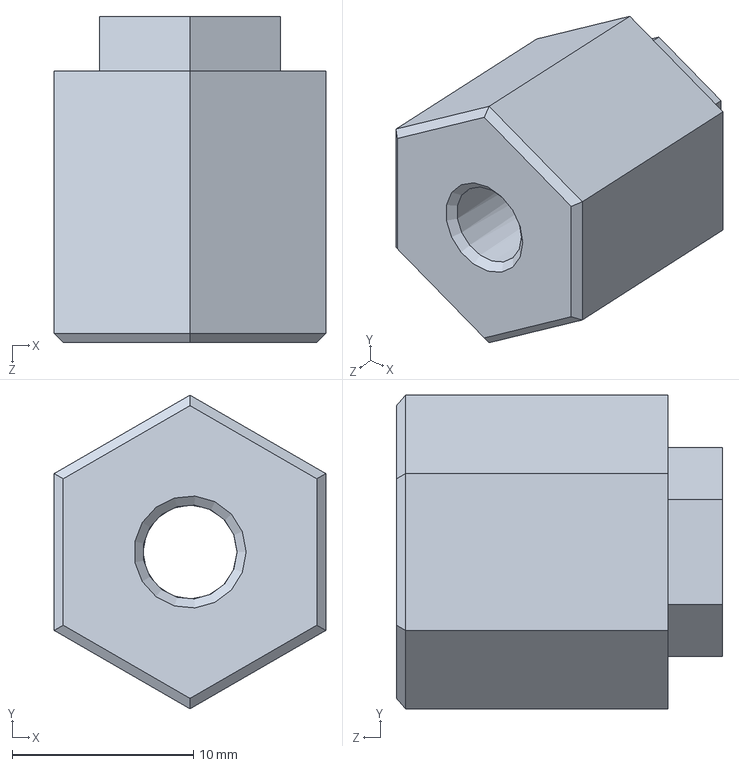
[picture p53: CAD file, 2024-03-26]
cad/gripper/middleconnector.SLDPRT
15.0 x 17.3 x 18.0 mm
