carologistics/hardware/cad/gripper/gripperflange.SLDPRT

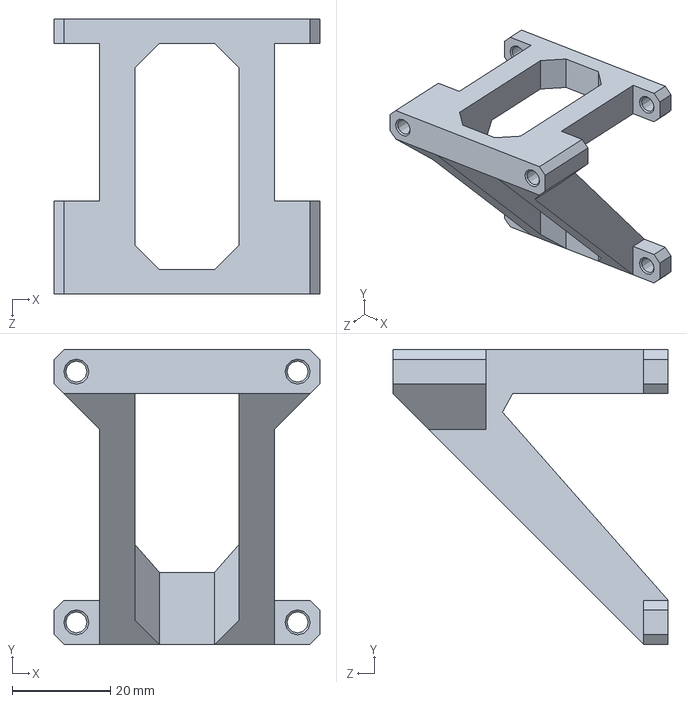
[picture p54: CAD file, 2024-03-26]
cad/gripper/gripperflange.SLDPRT
54.0 x 60.0 x 56.0 mm
