carologistics/hardware/cad/gripper/positioningdisk.SLDPRT

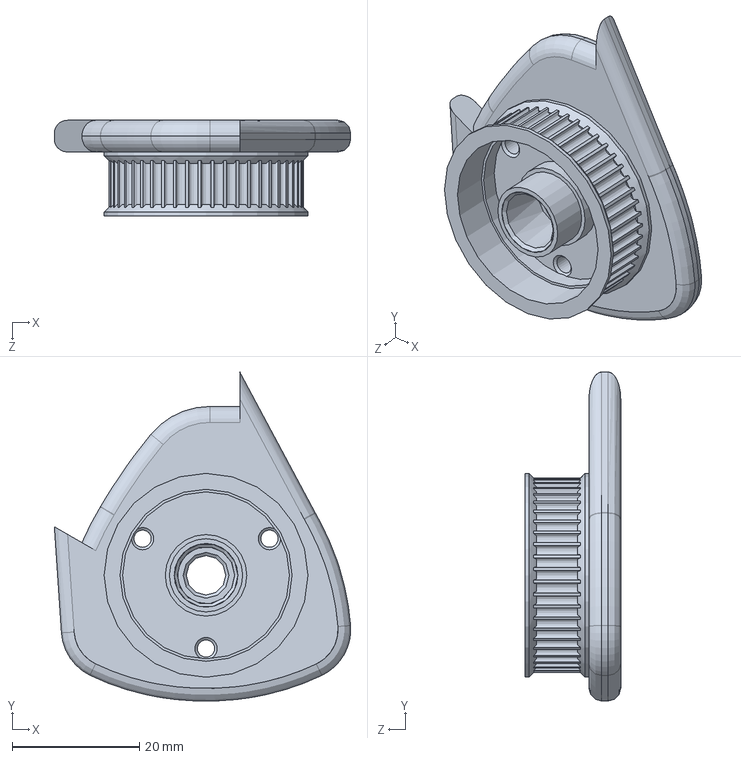
[picture p55: CAD file, 2024-03-26]
cad/gripper/positioningdisk.SLDPRT
46.5 x 51.6 x 15.0 mm
