carologistics/hardware/cad/norm_parts/spring.SLDPRT

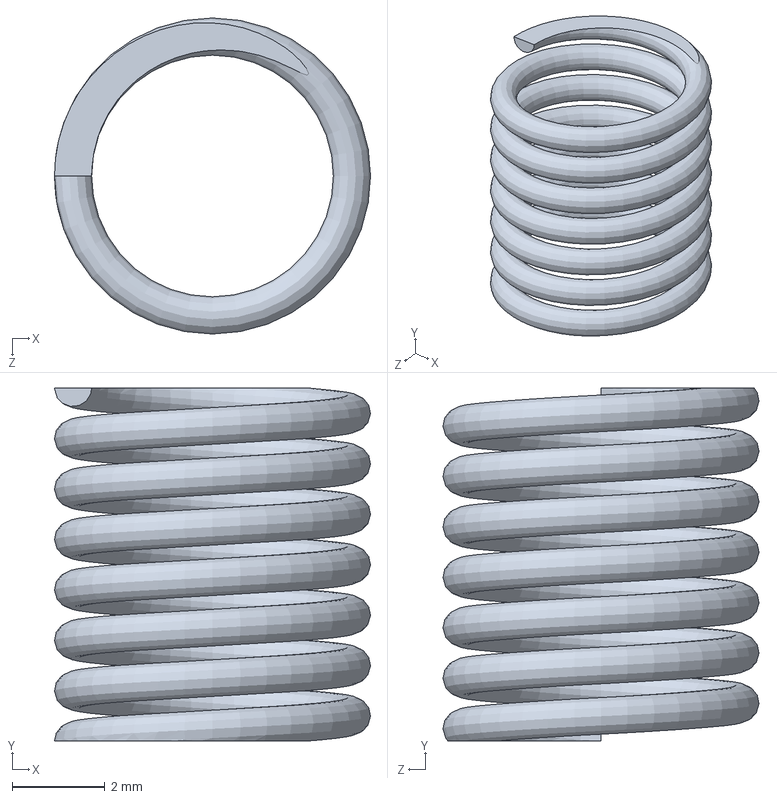
[picture p56: CAD file, 2024-03-26]
cad/norm_parts/spring.SLDPRT
6.80 x 7.59 x 6.80 mm
