carologistics/hardware/cad/gripper/backspacer.SLDPRT

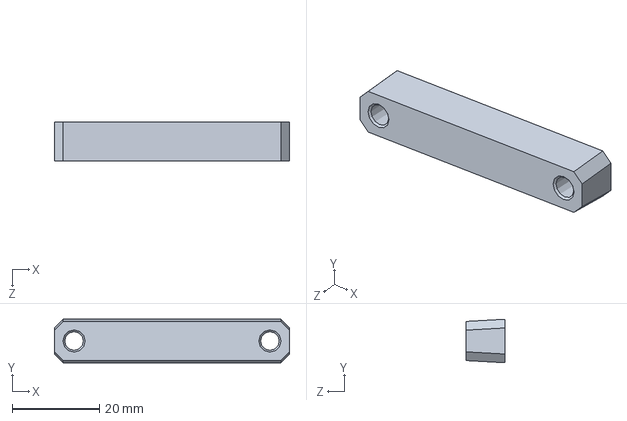
[picture p57: CAD file, 2024-03-26]
cad/gripper/backspacer.SLDPRT
54.0 x 10.0 x 9.00 mm
