carologistics/hardware/cad/gripper/contact.SLDPRT

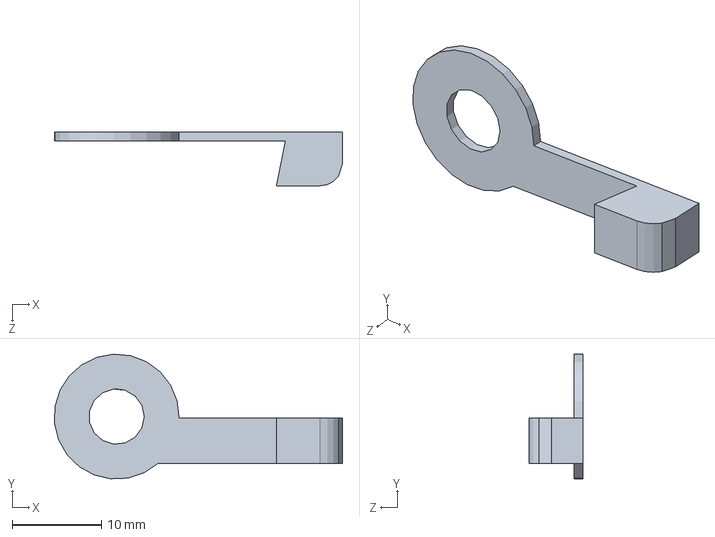
[picture p58: CAD file, 2024-03-26]
cad/gripper/contact.SLDPRT
32.3 x 14.0 x 6.00 mm
