carologistics/hardware/cad/norm_parts/parallelpin_3x25_iso_2338.SLDPRT

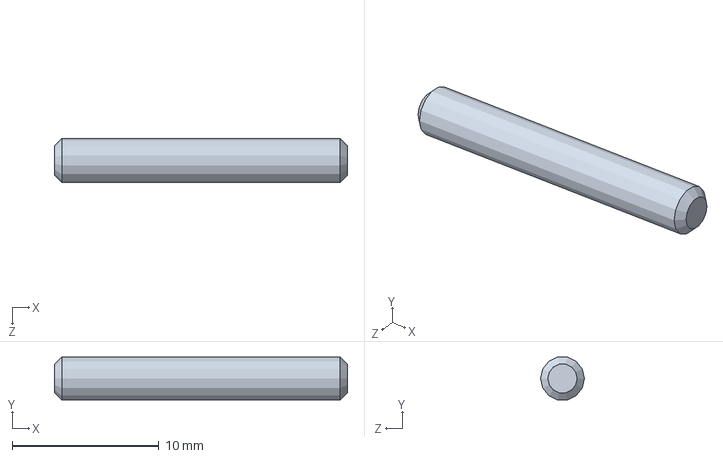
[picture p59: CAD file, 2024-03-26]
cad/norm_parts/parallelpin_3x25_iso_2338.SLDPRT
20.0 x 2.92 x 3.00 mm
