carologistics/hardware/cad/gripper/endstopmounting.SLDPRT

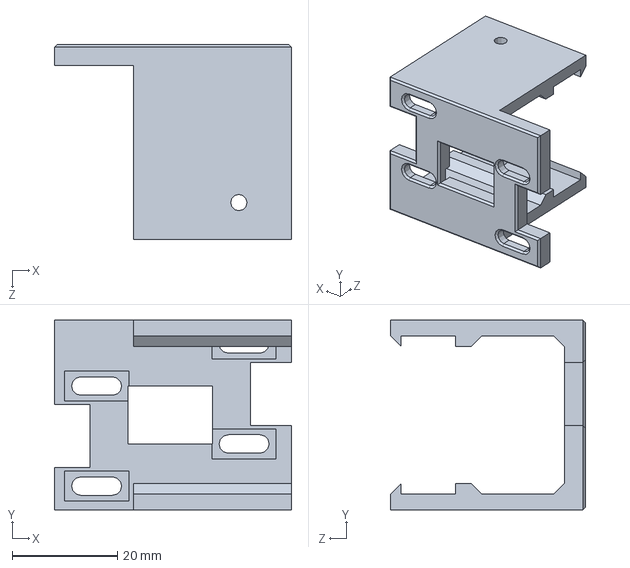
[picture p60: CAD file, 2019-09-30]
cad/gripper/endstopmounting.SLDPRT
45.0 x 36.0 x 37.0 mm
