carologistics/hardware/(list of files, cad)

Other CAD files:
cad/gripper/Gripper Version 2/stl/01-02-03 Gripper neu rechts.stl
cad/gripper/Gripper Version 2 (speziell deutsche Meisterschaft)/stl/01-03-01-01 Zeichnung Zange links unten.stl
cad/gripper/Gripper Version 2 (speziell deutsche Meisterschaft)/stl/01-03-02-01 Zeichnung Zange rechts.stl
cad/norm_parts/Nema17.SLDPRT
Notizen Akku Monitoring/Schutzbox technik.ipt
cad/axes/stl/tablecablechainmounting.STL
cad/axes/stl/uno_carrier.STL
cad/axes/stl/xaxisendstopmounting.STL
cad/axes/stl/yaxiscablechainmounting.STL
cad/axes/stl/yaxismounting.STL
cad/axes/stl/zaxisendstopmounting.STL
cad/axes/stl/zaxismounting.STL
cad/gripper/Gripper Version 1/00 Zeichnung Box.ipt
cad/gripper/Gripper Version 1/01 Gripper_System.iam
cad/gripper/Gripper Version 1/01-01 Gripper_Basis_Neu.ipt
cad/gripper/Gripper Version 1/01-02 Servo_Gripper.iam
cad/gripper/Gripper Version 1/01-02-01 Sandard-Servo.ipt
cad/gripper/Gripper Version 1/01-02-02 Gripper neu.ipt
cad/gripper/Gripper Version 1/01-03 Zangensystem Gripper unten.iam
cad/gripper/Gripper Version 1/01-03-01 Zange Links.iam
cad/gripper/Gripper Version 1/01-03-01-01 Zeichnung Zange links unten.ipt
cad/gripper/Gripper Version 1/01-03-01-02 Zeichnung Zange links oben.ipt
cad/gripper/Gripper Version 1/01-03-01-03 Schraube kl.ipt
cad/gripper/Gripper Version 1/01-03-02 Zange rechts.iam
cad/gripper/Gripper Version 1/01-03-02-01 Zeichnung Zange rechts.ipt
cad/gripper/Gripper Version 1/01-03-02-02 Zeichnung Zange rechts oben.ipt
cad/gripper/Gripper Version 1/01-03-03 Kugellager Tarik.ipt
cad/gripper/Gripper Version 1/01-03-04 Unterlegscheibe.ipt
cad/gripper/Gripper Version 1/01-03-05 Muttern.ipt
cad/gripper/Gripper Version 1/01-03-06 Schraube unten.ipt
cad/gripper/Gripper Version 1/01-05 Absicherung Richtung Kugellager.ipt
cad/gripper/Gripper Version 1/OldVersions/01-01 Gripper_Basis_Neu.0024.ipt
cad/gripper/Gripper Version 1/OldVersions/01-03-01-01 Zeichnung Zange links unten.0016.ipt
cad/gripper/Gripper Version 1/OldVersions/01-03-02-01 Zeichnung Zange rechts.0013.ipt
cad/gripper/Gripper Version 1/stl/01-01 Gripper_Basis_Neu.stl
cad/gripper/Gripper Version 1/stl/01-02-02 Gripper neu.stl
cad/gripper/Gripper Version 1/stl/01-03-01-01 Zeichnung Zange links unten.stl
cad/gripper/Gripper Version 1/stl/01-03-02-01 Zeichnung Zange rechts.stl
cad/gripper/Gripper Version 1/stl/01-03-02-02 Zeichnung Zange rechts oben.stl
cad/gripper/Gripper Version 2 (speziell deutsche Meisterschaft)/00 Zeichnung Box.ipt
cad/gripper/Gripper Version 2 (speziell deutsche Meisterschaft)/01 Gesamtsystem.iam
cad/gripper/Gripper Version 2 (speziell deutsche Meisterschaft)/01-01 Gripper_Basis_2 Servo System.ipt
cad/gripper/Gripper Version 2 (speziell deutsche Meisterschaft)/01-02-01 Sandard-Servo.ipt
cad/gripper/Gripper Version 2 (speziell deutsche Meisterschaft)/01-02-02 Gripper neu.ipt
cad/gripper/Gripper Version 2 (speziell deutsche Meisterschaft)/01-03-01 Zange Links.iam
cad/gripper/Gripper Version 2 (speziell deutsche Meisterschaft)/01-03-01-01 Zeichnung Zange links unten.ipt
cad/gripper/Gripper Version 2 (speziell deutsche Meisterschaft)/01-03-01-02 Zeichnung Zange links oben.ipt
cad/gripper/Gripper Version 2 (speziell deutsche Meisterschaft)/01-03-01-03 Schraube kl.ipt
cad/gripper/Gripper Version 2 (speziell deutsche Meisterschaft)/01-03-01-04 Kugellager Tarik.ipt
cad/gripper/Gripper Version 2 (speziell deutsche Meisterschaft)/01-03-02 Zange rechts.iam
cad/gripper/Gripper Version 2 (speziell deutsche Meisterschaft)/01-03-02-01 Zeichnung Zange rechts.ipt
cad/gripper/Gripper Version 2 (speziell deutsche Meisterschaft)/01-03-02-02 Zeichnung Zange rechts oben.ipt
cad/gripper/Gripper Version 2 (speziell deutsche Meisterschaft)/01-03-04 Unterlegscheibe.ipt
cad/gripper/Gripper Version 2 (speziell deutsche Meisterschaft)/01-03-05 Muttern.ipt
cad/gripper/Gripper Version 2 (speziell deutsche Meisterschaft)/01-03-06 Schraube unten.ipt
cad/gripper/Gripper Version 2 (speziell deutsche Meisterschaft)/01-05 Absicherung Richtung Kugellager.ipt
cad/gripper/Gripper Version 2 (speziell deutsche Meisterschaft)/OldVersions/01 Gesamtsystem.0006.iam
cad/gripper/Gripper Version 2 (speziell deutsche Meisterschaft)/OldVersions/01-01 Gripper_Basis_2 Servo System.0034.ipt
cad/gripper/Gripper Version 2 (speziell deutsche Meisterschaft)/OldVersions/01-02-02 Gripper neu.0031.ipt
cad/gripper/Gripper Version 2/00 Zeichnung Box.ipt
cad/gripper/Gripper Version 2/01 Gesamtsystem.iam
cad/gripper/Gripper Version 2/01-01 Gripper_Basis_2 Servo System.ipt
cad/gripper/Gripper Version 2/01-02-01 Sandard-Servo.ipt
cad/gripper/Gripper Version 2/01-02-02 Gripper neu links.ipt
cad/gripper/Gripper Version 2/01-02-03 Gripper neu rechts.ipt
cad/gripper/Gripper Version 2/01-03-01 Zange Links.iam
cad/gripper/Gripper Version 2/01-03-01-01 Zeichnung Zange links unten.ipt
cad/gripper/Gripper Version 2/01-03-01-02 Zeichnung Zange links oben.ipt
cad/gripper/Gripper Version 2/01-03-01-03 Schraube kl.ipt
cad/gripper/Gripper Version 2/01-03-01-04 Kugellager Tarik.ipt
cad/gripper/Gripper Version 2/01-03-02 Zange rechts.iam
cad/gripper/Gripper Version 2/01-03-02-01 Zeichnung Zange rechts.ipt
cad/gripper/Gripper Version 2/01-03-02-02 Zeichnung Zange rechts oben.ipt
cad/gripper/Gripper Version 2/01-03-04 Unterlegscheibe.ipt
cad/gripper/Gripper Version 2/01-03-05 Muttern.ipt
cad/gripper/Gripper Version 2/01-03-06 Schraube unten.ipt
cad/gripper/Gripper Version 2/01-05 Absicherung Richtung Kugellager.ipt
cad/gripper/Gripper Version 2/OldVersions/01-01 Gripper_Basis_2 Servo System.0032.ipt
cad/gripper/Gripper Version 2/OldVersions/01-02-02 Gripper neu links.0030.ipt
cad/gripper/Gripper Version 2/OldVersions/01-02-03 Gripper neu rechts.0029.ipt
cad/gripper/Gripper Version 2/OldVersions/01-03-01-01 Zeichnung Zange links unten.0020.ipt
cad/gripper/Gripper Version 2/OldVersions/01-03-02-01 Zeichnung Zange rechts.0015.ipt
cad/gripper/Item Z-Axis.ipt
cad/gripper/Querplattenaufsatz.ipt
cad/gripper/Seiten_Platte.ipt
cad/gripper/baseplatejoined.sldprt
cad/gripper/stl/assembled_positioningdisk.STL
cad/gripper/stl/backfinger.STL
cad/gripper/stl/backspacer.STL
cad/gripper/stl/baseplatejoined.STL
cad/gripper/stl/contact.STL
cad/gripper/stl/endstopmount.STL
cad/gripper/stl/frontfinger.STL
cad/gripper/stl/frontspacer.STL
cad/gripper/stl/gripperassembly.STL
cad/gripper/stl/gripperflange.STL
cad/gripper/stl/motormount.STL
cad/gripper/stl/positioningdisk.STL
cad/gripper/stl/supportprong.STL
cad/laser/stl/adapterplate.STL
cad/norm_parts/hex_socket_head_screw_m3x30_iso4762.SLDPRT
cad/norm_parts/hex_socket_head_screw_m6x50_iso4762.SLDPRT
cad/norm_parts/hex_socket_head_screw_m6x55_iso4762.SLDPRT
cad/norm_parts/washer_3mm_iso7089.SLDPRT
cad/norm_parts/washer_4mm_iso7089.SLDPRT
cad/norm_parts/washer_6mm_iso7089.SLDPRT
cad/realsense/stl/assemblytool.STL
cad/realsense/stl/blasterxmounting.STL
cad/realsense/stl/circuithousing.STL
cad/realsense/stl/d435mount.STL
cad/realsense/stl/mountingadapter.STL
cad/realsense/stl/positioningclamp.STL
cad/realsense/stl/rsmounting.STL
cad/realsense2/STL/base_rs2.STL
cad/realsense2/STL/mountflange_rs2.STL
cad/realsense2/STL/sliderjoint_rs2.STL
cad/robotino/stl/APmount.STL
cad/robotino/stl/backlaserbottom.STL
cad/robotino/stl/backlasertop.STL
cad/robotino/stl/frontlasermounting.STL
cad/robotino/stl/pcmountbot.STL
cad/robotino/stl/pcmountlaptop.STL
cad/robotino/stl/switchmount.STL
cad/robotino/stl/tagcameramounting.STL
