carologistics/hardware/Notizen Akku Monitoring/Schaltplan Akku Monitoring System.pdf

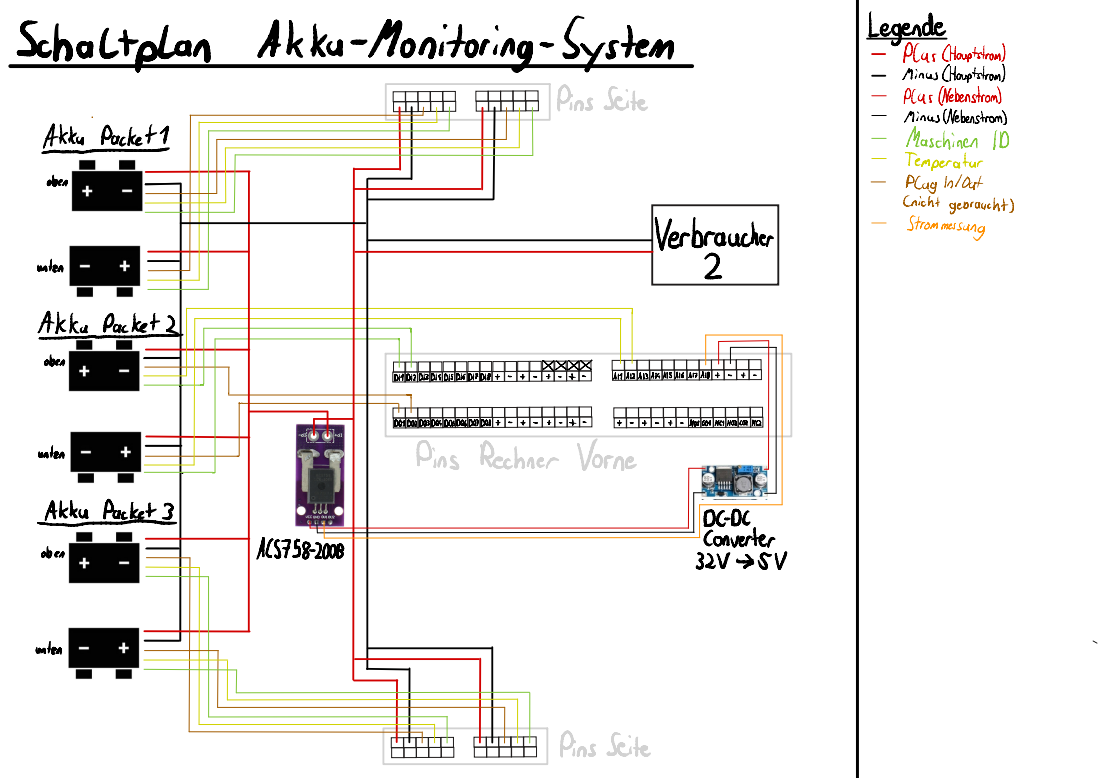
[picture p61: page 1]

เรีควรีวิว or
