carologistics/hardware/(commit log)

2018-12-04 cad: add positiondisk
    [positioningdisk.SLDPRT, positioningdisk.STL]
2018-12-04 cad: add all remaining gripper files
    [backfinger.SLDPRT, backfinger.STL, baseplate.SLDPRT, baseplate.STL, endstopmounting.SLDPRT, endstopmounting.STL, frontfinger.SLDPRT, frontfinger.STL]
2018-12-05 cad: add all axes mountings
    [grippermountingplate.SLDPRT, grippermountingplate.STL, positioningdisk.STL, xaxisendstopmounting.SLDPRT, xaxisendstopmounting.STL, yaxismounting.SLDPRT, yaxismounting.STL, zaxisendstopmounting.SLDPRT]
2018-12-05 cad: add realsense mounting files
    [mountingadapter.SLDPRT, mountingadapter.STL, rsmounting.SLDPRT, rsmounting.STL]
2018-12-07 cad: add gripperassembly
    [gripperassembly.SLDASM, gripperassembly.STL]
2018-12-09 cad: add lightbarriermounting
    [lightbarriermounting.SLDPRT, lightbarriermounting.STL]
2018-12-09 gripper: update gripperassembly with lightbarriermounting
    [gripperassembly.SLDASM, gripperassembly.STL]
2018-12-17 cad: change realsense mounting to fixed position
    [rsmounting.SLDPRT, rsmounting.STL]
2018-12-17 cad: modify baseplate for new realsense positioning
    [baseplate.SLDPRT, baseplate.STL]
2018-12-17 cad: modify lightbarriermounting for new realsense positioning
    [lightbarriermounting.SLDPRT, lightbarriermounting.STL]
2018-12-17 cad: update gripperassembly removing the possibility to mount realsense
    [gripperassembly.SLDASM, gripperassembly.STL]
2019-01-03 cad: add adapterplate for laserarmor
    [adapterplate.SLDPRT, adapterplate.STL]
2019-01-03 cad: modify fixed realsense mounting to lower angle
    [rsmounting.SLDPRT, rsmounting.STL]
2019-01-10 cad: move lightbarrier further away from gripperfingers
    [lightbarriermounting.SLDPRT, lightbarriermounting.STL]
2019-01-10 cad: add offset to center realsense lens
    [rsmounting.SLDPRT, rsmounting.STL]
2019-01-10 realsense: add cable support for usb cable
    [rsmounting.SLDPRT, rsmounting.STL]
2019-01-10 realsense: add circuithousing
    [circuithousing.SLDPRT, circuithousing.STL]
2019-01-10 axes: improve printability of yaxismounting
    [yaxismounting.SLDPRT, yaxismounting.STL]
2019-01-10 axes: improve printability of zaxismounting
    [zaxismounting.SLDPRT, zaxismounting.STL]
2019-01-10 realsense: thicken the walls of circuithousing
    [circuithousing.SLDPRT, circuithousing.STL]
2019-01-11 realsense: fix measurements of circuithousing
    [circuithousing.SLDPRT, circuithousing.STL]
2019-01-11 realsense: update offset measurements to center the lens
    [rsmounting.SLDPRT, rsmounting.STL]
2019-01-17 realsense: move mounting holes for rsmounting one mm further down
    [rsmounting.SLDPRT, rsmounting.STL]
2019-01-17 laser: fix dimensions of adapterplate
    [adapterplate.SLDPRT, adapterplate.STL]
2019-01-17 gripper: add mounting holes for fiber optic amplifier on baseplate
    [baseplate.SLDPRT, baseplate.STL]
2019-01-17 gripper: update gripperassembly
    to represent recent model changes
    [gripperassembly.SLDASM, gripperassembly.STL]
2019-01-17 realsense: remove barrier in circuithousing
    [circuithousing.SLDPRT, circuithousing.STL]
2019-01-17 laser: add chamfer on adapterplate
    to improve quality of 3d print
    [adapterplate.SLDPRT, adapterplate.STL]
2019-01-18 realsense: add mount for the new d435 realsense
    [d435mount.SLDPRT, d435mount.STL]
2019-01-18 realsense: move mounting holes to center the FOV
    instead of centering the coordinate origin
    [d435mount.SLDPRT, d435mount.STL]
2019-02-01 rsmounting: add plane as construction geometry
    for grabbing camera offset measurements
    [rsmounting.SLDPRT]
2019-02-01 realsense: switch mounting position to bottom of z-axis
    [rsmounting.SLDPRT, rsmounting.STL]
2019-02-01 realsense: add tool to center realsense
    the position of the realsense is not fixed within the new mounting
    brackets. with this tool it is possibly to center the realsense.
    [assemblytool.SLDPRT, assemblytool.STL]
2019-02-01 axes: rotate orientation of z-axis by 180 degrees
    the new gripper profits from more clearence in the top parts of the
    z-axis. weight distribution is optimized aswell, as the z-axis stepper
    is now at the bottom.
    [zaxismounting.SLDPRT, zaxismounting.STL]
2019-02-08 robotino: add new mounting for the tag camera
    the camera is positioned further back for a bigger field of view #3
    [tagcameramounting.SLDPRT, tagcameramounting.STL]
2019-02-08 tagcameramounting: add extrudes to define position
    the extrudes fit into the cutouts on the tower any rotation or lateral
    play will be blocked by them. #3
    [tagcameramounting.SLDPRT, tagcameramounting.STL]
2019-02-08 tagcameramounting: improve printability
    the extrudes on the backside are now able to be printed without support
    [tagcameramounting.SLDPRT, tagcameramounting.STL]
2019-02-13 gripper: decrease measurements at the base of the baseplate
    the baseplate was standing out of the z-axis table
    [baseplate.SLDPRT, baseplate.STL]
2019-02-13 gripper: decrease base size of lightbarriermounting
    the base was standing out over the brim of the z-axis table
    [lightbarriermounting.SLDPRT, lightbarriermounting.STL]
2019-02-18 tagcameramounting: decrease clearances for tighter fit
    the camera sits more snug now #3
    [tagcameramounting.SLDPRT, tagcameramounting.STL]
2019-02-18 gripper: widen the m6 bore of the middleconnector
    this improves the assembly of the gripper
    [middleconnector.SLDPRT, middleconnector.STL]
2019-02-18 gripper: increase clearence of holding brackets
    [endstopmounting.SLDPRT, endstopmounting.STL]
2019-02-18 gripper/enstopmounting: increase size of m3 nut slots
    [endstopmounting.SLDPRT, endstopmounting.STL]
2019-02-18 gripper: update gripperassembly to show recent changes
    [gripperassembly.SLDASM, gripperassembly.STL]
2019-02-22 robotino/tagcameramounting: add clampingmechanism
    The tagcamera had some play when mounted. Now it is possible to clamp
    the camera in place via an M3 screw at the top. #3
    [tagcameramounting.SLDPRT, tagcameramounting.STL]
2019-02-22 gripper/frontfinger: add groove for o-ring
    It is now possible to add an o-ring to the frontfingers to increase
    the hold of the puck.
    [frontfinger.SLDPRT, frontfinger.STL]
2019-02-23 gripper/frontfinger: switch groove for o-ring to other side
    [frontfinger.SLDPRT, frontfinger.STL]
2019-02-23 gripper/backfinger: add groove for o-ring
    The o-ring at the tip of the finger increases friction when gripping.
    [backfinger.SLDPRT, backfinger.STL]
2019-02-23 gripper/gripperassembly: update model to show recent changes
    [gripperassembly.SLDASM, gripperassembly.STL]
2019-02-24 gripper/stopper: decrease hole diameter for brass rod
    [stopper.SLDPRT, stopper.STL]
2019-02-24 gripper/stopper: change bore for m3 screw to fit brass rod
    Remove the mounting holes for the M3 screw, switching to a simple blind
    hole to fit an 2,9mm brass rod. #5
    [stopper.SLDPRT, stopper.STL]
2019-02-24 gripper/middleconnector: decrease diameter of blind holes
    Switching from the M3 screw to the 2.9mm brass rod, the blind holes on
    the side of the middleconnetor can be decreased by 0.2mm. #5
    [middleconnector.SLDPRT, middleconnector.STL]
2019-02-24 gripper/baseplate: decrease diameter of m3 bores
    Switching from M3 screws to simple 2.9mm brass rods for mounting the
    stoppers, the diameter of those needed bores are being adjusted.
    [baseplate.SLDPRT, baseplate.STL]
2019-02-24 gripper/endstopmounting: decrease diameter of m3 bore
    Switching from an M3 screw to mount the endstopmounting to a 2.9mm brass
    rod, the bore for this connection is being adjusted.
    [endstopmounting.SLDPRT, endstopmounting.STL]
2019-03-08 gripper/middleconnector: increase extrude for m6 nut
    this improves the assembly
    [middleconnector.SLDPRT, middleconnector.STL]
2019-03-08 gripper/gripperassembly: update model to show changes
    [gripperassembly.SLDASM, gripperassembly.STL]
2019-03-09 robotino: add frontlasermounting
    to make use of the new laser armor a new mounting is needed #4
    [frontlasermounting.SLDPRT, frontlasermounting.STL]
2019-03-10 robotino/frontlasermounting: add chamfers
    [frontlasermounting.SLDPRT, frontlasermounting.STL]
2019-03-11 robotino/frontlasermounting: remove counterbore
    this improves printability #4
    [frontlasermounting.SLDPRT, frontlasermounting.STL]
2019-03-13 gripper/frontfinger: decrease width
    this increases play between baseplate and finger
    [frontfinger.SLDPRT]
2019-03-13 gripper/frontfinger: decrease size of bore
    this is in relation to using the brass rod instead of m3 srews
    [frontfinger.SLDPRT]
2019-03-13 gripper/backfinger: decrease width
    this inreases play between baseplate and finger
    [backfinger.SLDPRT]
2019-03-13 robotino/frontlasermounting: update model view
    [frontlasermounting.SLDPRT]
2019-03-13 gripper/backfinger: decrease size of bore
    this is in relation to using the brass rod instead of m3 screws
    [backfinger.SLDPRT]
2019-03-13 gripper/stl: update stls of gripperfingers
    [backfinger.STL, frontfinger.STL]
2019-03-14 robotino/frontlasermounting: delete unnecessary features
    this is the first step in switching the mounting position of the front
    laser to the tower of the robotino as mentioned in issue #4. All
    unnecessary features of the previous mount have been deleted.
    [frontlasermounting.SLDPRT]
2019-03-14 robotino/frontlasermounting: add m5 counterbores
    this adds the bore for the M5 screws which will connect the
    lasermounting with the robotino tower #4
    [frontlasermounting.SLDPRT]
2019-03-14 robotino/frontlasermounting: remove excess material
    [frontlasermounting.SLDPRT]
2019-03-14 robotino/stl: update stl of frontlasermounting
    this shows the most recent changes #4
    [frontlasermounting.STL]
2019-03-14 axes: add y-axis cablechainmounting
    [yaxiscablechainmounting.SLDPRT]
2019-03-14 axes/yaxiscablechainmounting: add 2.8mm bores
    [yaxiscablechainmounting.SLDPRT, yaxiscablechainmounting.STL]
2019-03-14 axes/yaxiscablechainmounting: add standoff for m6
    this prevents colliding of the head of the m6 screw and the cablechain
    [yaxiscablechainmounting.SLDPRT, yaxiscablechainmounting.STL]
2019-03-15 axes: add table mountingadapter for cablechain
    this connects the robotino table with the cablechain. It utilizes the
    hole pattern of the table
    [tablecablechainmounting.SLDPRT, tablecablechainmounting.STL]
2019-03-16 gripper: add flange for steppermotor
    The stepper for the gripper is now mounted from below, which improves
    its assembly and the maintenance of the grippers backfinger.
    [stepperflange.SLDPRT, stepperflange.STL]
2019-03-16 gripper/gripperassembly: add stepperflange
    [gripperassembly.SLDASM, gripperassembly.STL]
2019-03-19 robotino/frontlasermounting: increase hole distance
    [frontlasermounting.SLDPRT, frontlasermounting.STL]
2019-03-21 robotino/frontlasermounting: center mountingholes
    The mountingholes for the laser are moved 1.5mm further down. So now it
    does not matter in which direction you mount the lasermounting.
    [frontlasermounting.SLDPRT, frontlasermounting.STL]
2019-03-21 axes/yaxiscablechainmounting: increase height
    [yaxiscablechainmounting.SLDPRT, yaxiscablechainmounting.STL]
2019-03-21 axes/tablecablechainmounting: move mountingholes offcenter
    [tablecablechainmounting.SLDPRT, tablecablechainmounting.STL]
2019-04-07 robotino/frontlasermounting: add construction geometries
    [frontlasermounting.SLDPRT]
2019-04-07 robotino: add first part for new backlasermounting
    This is still a work in progress and not fully designed yet #4
    [backlaserbottom.SLDPRT]
2019-04-12 robotino: add new laptop mounting system
    [pcmountbot.SLDPRT, pcmountbot.STL, pcmountlaptop.SLDPRT, pcmountlaptop.STL]
2019-04-12 axes/zaxismounting: deepen counterbores for m5 screws
    This is to utilize the M5x25 screws we already have
    [zaxismounting.SLDPRT, zaxismounting.STL]
2019-04-12 gripper/backfinger: extend finger further down
    [backfinger.SLDPRT, backfinger.STL]
2019-04-12 gripper/frontfinger: extend finger further down
    [frontfinger.SLDPRT, frontfinger.STL]
2019-04-12 realsense/rsmounting: rotate realsense by 180deg
    [rsmounting.SLDPRT, rsmounting.STL]
2019-04-12 gripper: move lightbarrier further to the side
    [lightbarriermounting.SLDPRT, lightbarriermounting.STL]
2019-04-13 robotino/pcmountbot: increase size
    this minimizes clearence between the two parts of the pc mount
    [pcmountbot.SLDPRT, pcmountbot.STL]
2019-04-13 robotino/pcmountlaptop: remove bores
    [pcmountlaptop.SLDPRT, pcmountlaptop.STL]
2019-04-13 robotino: redesign the lower part of backlasermounting
    the holes do now align with the ones on the tower #4
    [backlaserbottom.SLDPRT, backlaserbottom.STL]
2019-04-13 robotino: add upper part for the backlasermounting
    this completes the new backlaser mountingsystem, together with
    backlaserbottom and frontlasermounting. #4
    [backlasertop.SLDPRT, backlasertop.STL]
2019-04-28 config: add accesspoint configuration file
    current configuration is with dhcp disabled and 2,4GHz turned off #6
    [accesspoint.cfg]
2019-04-28 realsense: add positioningclamp
    this fixes the realsense in the Y direction #7
    [positioningclamp.SLDPRT, positioningclamp.STL]
2019-04-29 realsense/rsmounting: add extruded cut for positioningclamp
    helps with issue #7
    [rsmounting.SLDPRT, rsmounting.STL]
2019-04-29 realsense/positioningclamp: modify cut outs
    with this its possible to fit the positioningclamp on to the
    realsensemounting #7
    [positioningclamp.SLDPRT, positioningclamp.STL]
2019-05-01 backlasermounting: add cutouts for M5 nuts
    [backlaserbottom.SLDPRT, backlaserbottom.STL, backlasertop.SLDPRT, backlasertop.STL]
2019-05-01 backlasermounting: widen M5 screw clearence
    [backlasertop.SLDPRT, backlasertop.STL]
2019-05-02 backlaserbottom: make part stronger
    [backlaserbottom.SLDPRT, backlaserbottom.STL]
2019-05-02 backlaserbottom: add counter bore for M5 hex screw
    [backlaserbottom.SLDPRT, backlaserbottom.STL]
2019-05-02 lightbarriermounting: add chamfered corner
    [lightbarriermounting.SLDPRT, lightbarriermounting.STL]
2019-05-02 lightbarriermounting: mirror part
    this prevents the lightbarrier from getting interference from the
    realsense
    [lightbarriermounting_rightside.SLDPRT, lightbarriermounting_rightside.STL]
2019-05-02 lightbarriermounting: even out thickness of part
    [lightbarriermounting.SLDPRT, lightbarriermounting.STL, lightbarriermounting_rightside.SLDPRT, lightbarriermounting_rightside.STL]
2019-05-03 lightbarriermounting: lower lightbarrier down by 1cm
    [lightbarriermounting.SLDPRT, lightbarriermounting.STL, lightbarriermounting_rightside.SLDPRT, lightbarriermounting_rightside.STL]
2019-05-08 gripper/backfinger: widen grippingplane
    the finger now has a wider bottom, which prevents a workpiece from
    slipping between back and frontfinger. This should be tested in relation
    to issue #12
    [backfinger.SLDPRT, backfinger.STL]
2019-05-09 gripper/backfinger: reduce thickness to 4mm
    [backfinger.SLDPRT]
2019-05-09 gripper/backfinger: add prism
    [backfinger.SLDPRT, backfinger.STL]
2019-05-18 gripper/backfinger: add holes to incoporate protection buffer
    [backfinger.SLDPRT, backfinger.STL]
2019-06-04 gripper/frontfinger: remove groove for rubberband
    [frontfinger.SLDPRT]
2019-06-04 gripper/frontfinger: add hole to incorporate protection buffer
    [frontfinger.SLDPRT, frontfinger.STL]
2019-06-14 realsense: add mounting for new realsense
    [blasterxmounting.SLDPRT, blasterxmounting.STL]
2019-06-17 realsense/blasterxmounting: move realsense 3mm outward
    [blasterxmounting.SLDPRT, blasterxmounting.STL]
2019-06-18 This is the initial commit for the gcode folder.
    The gcode folder contains all cad parts, ready to be printed. As well as
    a Readme file, which explains how to start a printjob on the Prusa
    Printer.
2019-06-25 robotino: add mountingadapter for new switches
    [switchmount.SLDPRT, switchmount.STL]
2019-06-25 gcode: add gcode file for switchmount
2019-06-25 robotino/switchmount: add counterbore for M5 screw
    [switchmount.SLDPRT, switchmount.STL]
2019-06-25 gcode/switchmount: update gcode file
2019-07-02 gripper/backfinger: tighten long hole
    the diameter of the long hole has been reduced from 3,6mm to 3,2mm. This
    prevents the spring from getting caught between the brass rod and the
    finger.
    [backfinger.SLDPRT, backfinger.STL]
2019-07-02 gripper/frontfinger: tighten long hole
    this reduces the diameter of the long hole from 3,6mm to 3,2mm,
    preventing the spring from getting stuck between finger and brass rod.
    [frontfinger.SLDPRT, frontfinger.STL]
2019-07-02 gripper: update gripperassembly
    [gripperassembly.SLDASM, gripperassembly.STL]
2019-07-02 endstopmounting: slim down mounting clamp
    [endstopmounting.SLDPRT]
2019-07-02 middleconnector: extrude hex
    [middleconnector.SLDPRT, middleconnector.STL]
2019-07-06 baseplate: change hex measurements
    [baseplate.SLDPRT]
2019-07-06 backfinger: even out gripping areas
    [backfinger.SLDPRT]
2019-07-06 backfinger: add chamfer for design purposes
    [backfinger.SLDPRT]
2019-07-06 baseplate: cut away motormounting
    [baseplate.SLDPRT]
2019-07-06 gripper: add motormount
    [motormount.SLDPRT]
2019-07-06 gripper: update assembly with new parts
    [gripperassembly.SLDASM]
2019-09-19 gripper/frontfinger: change mounting to hole
    a brass rod is more suitable for mounting the finger, than an extrude of
    the main body itself. this switches the extrude to a hole
    [frontfinger.SLDPRT]
2019-09-19 gripper/backfinger: switch mounting to hole
    as with the frontfinger, it is better to mount the backfinger on a brass
    rod.
    [backfinger.SLDPRT]
2019-09-19 gripper/baseplate: remove slots for gripperfingers
    as the gripper fingers will be mounted with the brass rods, the slots to
    mount them in are no longer needed
    [baseplate.SLDPRT]
2019-09-19 gripper/baseplate: move brass-rod-holes further inward
    [baseplate.SLDPRT]
2019-09-19 gripper/baseplate: merge stopper with baseplate
    [baseplate.SLDPRT]
2019-09-19 gripper/stopper: remove model
    since the stoper is now merged with the baseplate, it is no longer
    needed
    [stopper.SLDPRT]
2019-09-19 gripper/motormount: update appearance
    [motormount.SLDPRT]
2019-09-19 gripperassembly: update to show recent changes
    [gripperassembly.SLDASM]
2019-09-19 gripper/stepperflange: remove part
    [stepperflange.SLDPRT]
2019-09-19 gripper/middleconnector: run brassrod holes through whole part
    [middleconnector.SLDPRT]
2019-09-21 gripper/backfinger: add slot for copper wire
    [backfinger.SLDPRT, backfinger.STL]
2019-09-23 gripper/backfinger: move slot to top
    [backfinger.SLDPRT, backfinger.STL]
2019-09-23 gripper/positioningdisk: add slot
    [positioningdisk.SLDPRT, positioningdisk.STL]
2019-09-24 gripper/positioningdisk: move slot inside of part
    [positioningdisk.SLDPRT, positioningdisk.STL]
2019-09-30 gripper/stl: update stl models
    [baseplate.STL, frontfinger.STL, middleconnector.STL, motormount.STL]
2019-09-30 gripper: update files to newer solidworks version
    [backfinger.SLDPRT, baseplate.SLDPRT, endstopmounting.SLDPRT, frontfinger.SLDPRT, gripperassembly.SLDASM, lightbarriermounting_rightside.SLDPRT, middleconnector.SLDPRT, positioningdisk.SLDPRT]
2019-10-24 axes/yaxismounting: update color
    [yaxismounting.SLDPRT]
2019-10-24 gripper/lightbarriermounting: update color
    [lightbarriermounting_rightside.SLDPRT]
2019-10-24 realsense/blasterxmounting: update color
    [blasterxmounting.SLDPRT]
2019-10-24 gripper/motormount: slim down main body
    [motormount.SLDPRT, motormount.STL]
2019-11-17 gripper: add gripperflange
    [gripperflange.SLDPRT, gripperflange.STL]
2019-11-17 gripperflange: improve force distributuion
    [gripperflange.SLDPRT, gripperflange.STL]
2019-11-17 backfinger: remove copper wire slot
    [backfinger.SLDPRT, backfinger.STL]
2019-12-18 baseplate: strengthen mountingpoints
    [baseplate.SLDPRT]
2019-12-18 middleconnector: tweak measuremnts for joining
    [middleconnector.SLDPRT]
2019-12-18 joinedbaseplate: this part merges the middleconnector and baseplate
    this is to strenthen the part and prevent deformation
    [baseplatejoined.SLDASM, joinedbaseplate.sldprt]
2019-12-18 baseplate: reduce screw clearance
    [baseplate.SLDPRT]
2019-12-18 joinedbaseplate: update part
    [baseplatejoined.SLDASM, joinedbaseplate.sldprt]
2019-12-18 middleconnector: remove chamfer
    [middleconnector.SLDPRT]
2019-12-18 update stl files
    [joinedbaseplate.STL]
2019-12-18 remove obsolete stl files
    [baseplate.STL, endstopmounting.STL, lightbarriermounting.STL, lightbarriermounting_rightside.STL, middleconnector.STL, stepperflange.STL, stopper.STL]
2019-12-18 update gripperassembly to show recent changes
    [gripperassembly.SLDASM, gripperassembly.STL]
2019-12-18 gripperassembly: update distances between parts
    [gripperassembly.SLDASM, gripperassembly.STL]
2019-12-18 baseplate: add chamfers to increase aerodynamics
    [baseplate.SLDPRT, baseplatejoined.SLDASM, joinedbaseplate.STL, joinedbaseplate.sldprt]
2019-12-18 gripperflange: add chamfer to mountingholes
    [gripperflange.SLDPRT, gripperflange.STL]
2020-01-13 backfinger: remove lever for endstop
    [backfinger.SLDPRT, backfinger.STL]
2020-01-13 baseplate: reduce tlerances of mounting holes
    [baseplate.SLDPRT, joinedbaseplate.STL, joinedbaseplate.sldprt]
2020-01-13 motormount: reduce tolerances of mounting holes
    [motormount.SLDPRT, motormount.STL]
2020-01-13 gripperflange: reduce tolerances of mounting holes
    [gripperflange.SLDPRT, gripperflange.STL]
2020-01-13 frontspacer: add new part
    this part defines the distance between the baseplate and the motormount,
    resulting in the correct belt tension.
    [frontspacer.SLDPRT, frontspacer.STL]
2020-01-13 backspacer: add new part
    this part is a spacer between the motormount and the gripperflange. it
    defines the correct distance between those two parts.
    [backspacer.SLDPRT, backspacer.STL]
2020-02-07 gripper: update assembly
    [gripperassembly.SLDASM, joinedbaseplate.sldprt]
2020-02-07 positioningdisk: remove bore for wire
    [positioningdisk.SLDPRT, positioningdisk.STL]
2020-06-05 backfinger: cut slot for ease of assembly
    [backfinger.SLDPRT, backfinger.STL]
2020-06-05 frontfinger: cut slot for ease of assembly
    [frontfinger.SLDPRT, frontfinger.STL]
2020-06-07 backfinger: add mounting hole for sensor cable
    [backfinger.SLDPRT, backfinger.STL]
2020-06-07 backfinger: add notch for isolator
    [backfinger.SLDPRT, backfinger.STL]
2020-06-07 gripper: add isolator for backfinger
    [isolator.SLDPRT, isolator.STL]
2020-06-08 baseplate: tighten hole tolerances for brass rods
    [baseplate.SLDPRT, baseplatejoined.SLDASM, joinedbaseplate.STL, joinedbaseplate.sldprt, middleconnector.SLDPRT]
2020-06-08 backfinger: move isolator further down
    [backfinger.SLDPRT, backfinger.STL, isolator.SLDPRT, isolator.STL]
2020-08-15 gripperflange: add supports for printing
    [gripperflange_support.STL]
2020-08-16 baseplate: add insulation between brassrods and M6 screw
    [baseplate.SLDPRT, baseplatejoined.SLDASM, joinedbaseplate.STL, joinedbaseplate.sldprt, middleconnector.SLDPRT]
2020-08-16 backfinger: increase diameter for cable connection
    [backfinger.SLDPRT, backfinger.STL]
2020-08-16 backfinger: optimize electric contact area
    [backfinger.SLDPRT, backfinger.STL]
2020-10-10 increase contact area between positioningdisk and backfinger
    [backfinger.SLDPRT, positioningdisk.SLDPRT, positioningdisk.STL]
2020-10-10 update STL filename of baseplatejoined to be less confusing
    [baseplatejoined.SLDASM, baseplatejoined.STL, joinedbaseplate.STL]
2020-10-10 initial commit for the endstopmount
    [endstopmount.SLDPRT, endstopmount.STL]
2020-10-12 gripper: remove unneeded models for this gripper version
    [endstopmounting.SLDPRT, lightbarriermounting.SLDPRT, lightbarriermounting_rightside.SLDPRT]
2020-10-12 baseplatejoined: update naming of the part file
    it got confusing with the two names "joinedbaseplate" and "baseplatejoined"
    [baseplatejoined.SLDASM, baseplatejoined.sldprt, gripperassembly.SLDASM, gripperassembly.STL, joinedbaseplate.sldprt]
2020-10-12 baseplatejoined: decrease length for brass rod
    [baseplate.SLDPRT, baseplatejoined.SLDASM, baseplatejoined.STL, baseplatejoined.sldprt, gripperassembly.SLDASM, gripperassembly.STL, middleconnector.SLDPRT]
2020-10-13 positioningdisk: decrease tolerance for M6 screw
    [positioningdisk.SLDPRT, positioningdisk.STL]
2020-10-15 backfinger: optimize contact to positioningdisk
    [backfinger.SLDPRT, backfinger.STL, isolator.SLDPRT, isolator.STL]
2020-10-15 baseplatejoined: add screw clearence for shaft screw
    [baseplatejoined.STL, baseplatejoined.sldprt]
2020-10-15 endstopmount: change color of model
    [endstopmount.SLDPRT]
2020-10-21 positioningdisk: add chamfer on contact area
    this improves the contact between backfinger an positioningdisk, as the
    3dprinted part will have a more even surface
    [positioningdisk.SLDPRT, positioningdisk.STL]
2020-10-22 positioningdisk: decrease tolerance for bearing
    [positioningdisk.SLDPRT, positioningdisk.STL]
2020-11-07 positioningdisk: add cut out
    [positioningdisk.SLDPRT, positioningdisk.STL]
2020-11-07 remove isolator
    [backfinger.SLDPRT, backfinger.STL, isolator.SLDPRT, isolator.STL]
2020-11-07 contact: initial commit
    [contact.SLDPRT, contact.STL]
2020-11-07 positioningdisk: fit cutout to contact
    [positioningdisk.SLDPRT, positioningdisk.STL]
2020-11-07 flip chamfer on positioningdisk and contact
    [assembled_positioningdisk.SLDASM, contact.SLDPRT, contact.STL, positioningdisk.SLDPRT, positioningdisk.STL]
2021-01-20 initial commit for norm parts
    [hexbolt_m6x50_iso4762.SLDPRT, hexnut_m4_iso4032.SLDPRT, hexnut_m6_iso4032.SLDPRT, parallelpin_3x30_iso_2338.SLDPRT, threadedrod_m4x170.SLDPRT, washer_4mm_iso7089.SLDPRT, washer_6mm_iso7089.SLDPRT]
2021-01-20 gripper: update color of cad models
    [backspacer.SLDPRT, baseplatejoined.sldprt, endstopmount.SLDPRT, frontfinger.SLDPRT, frontspacer.SLDPRT, gripperassembly.SLDASM, gripperflange.SLDPRT, motormount.SLDPRT]
2021-01-20 stl: update gripperassembly to show recent changes
2021-02-04 baseplate: increase counterbore for longer screw
    [baseplatejoined.STL, baseplatejoined.sldprt]
2021-02-04 gripper: add spring to gripperassembly
    [gripperassembly.SLDASM, spring.SLDPRT]
2021-02-04 norm_parts: initial commit for m6x55 bolt
    [hexbolt_m6x55_iso4762.SLDPRT]
2021-02-20 norm_parts: correct name of socket head screw
    [hex_socket_head_screw_m6x50_iso4762.SLDPRT, hex_socket_head_screw_m6x55_iso4762.SLDPRT, hexbolt_m6x50_iso4762.SLDPRT, hexbolt_m6x55_iso4762.SLDPRT]
2021-02-20 norm_parts: create model of nema14 stepper motor
    [Nema14.SLDPRT]
2021-02-20 norm_parts: create model of m3x30 socket head screw
    [hex_socket_head_screw_m3x30_iso4762.SLDPRT]
2021-02-20 norm_parts: create model of 3mm washer
    [washer_3mm_iso7089.SLDPRT]
2021-02-20 gripper: update files in color and resolution
    [backfinger.STL, backspacer.STL, baseplatejoined.SLDASM, baseplatejoined.STL, baseplatejoined.sldprt, contact.STL, endstopmount.STL, frontfinger.SLDPRT]
2021-02-20 axes: remove grippermountingplate
    [grippermountingplate.SLDPRT, grippermountingplate.STL]
2021-02-20 axes: increase height of cablechainmount
    [tablecablechainmounting.SLDPRT, tablecablechainmounting.STL]
2021-05-26 positioningdisk: increase tolerance for bearing
    [positioningdisk.SLDPRT, positioningdisk.STL]
2021-06-07 yaxismounting: remove endstopmount on far side of axis
    [yaxismounting.SLDPRT, yaxismounting.STL]
2021-06-07 zaxismounting: remove mountingholes for arduino
    [zaxismounting.SLDPRT, zaxismounting.STL]
2021-06-07 axes: initial commit for the aruino uno carrier
    the arduino gets its own mounting adapter. positioning it higher up and
    reducing the danger of wires getting caught in the axes
    [uno_carrier.SLDPRT, uno_carrier.STL]
2021-06-10 uno_carrier: add cutouts to make space for pins
    [uno_carrier.SLDPRT, uno_carrier.STL]
2021-06-10 frontlasermounting: remove chamfer to optimize printability
    [frontlasermounting.SLDPRT, frontlasermounting.STL]
2021-06-10 APmount: initial commit for the TP-Link AP mount
    [APmount.SLDPRT, APmount.STL]
2021-06-12 positioningdisk: increase tolerance for bearing by 0.2mm
    [positioningdisk.SLDPRT, positioningdisk.STL]
2021-06-15 gcode: add gcode for the TP-Link AP mount
2021-06-16 APmount: change extruded cut for the realsense cable
    with this new slot the cable can not escape the aluminiumextrusion
    slot and will therefore be better guided.
    [APmount.SLDPRT, APmount.STL]
2021-06-22 gcode: update all files to new gripper
2021-06-24 contact: increase dimensions
    [contact.SLDPRT, contact.STL]
2021-06-25 axes: update color of parts
    [yaxismounting.SLDPRT, zaxismounting.SLDPRT]
2021-06-25 backfinger: optimize filament usage
    [backfinger.SLDPRT, backfinger.STL]
2021-06-25 contact: improve contact area
    [contact.SLDPRT, contact.STL]
2021-06-25 assembled_posdisk: update assembly
    [assembled_positioningdisk.SLDASM]
2021-06-25 blasterxmounting: update color
    [blasterxmounting.SLDPRT]
2021-06-25 baseplate: include M6 thread in printed part
    [baseplatejoined.STL, baseplatejoined.sldprt]
2021-06-26 positioningdisk: now with axial ball bearing
    [positioningdisk.SLDPRT, positioningdisk.STL]
2021-06-26 gcode: update baseplate to include M6 thread
2021-06-26 gripper: update assembly parts
    [assembled_positioningdisk.SLDASM, spring.SLDPRT]
2023-04-29 rcll:/revision of gripper end-effector design and behavior
    [Nema14.SLDPRT, assembled_positioningdisk.SLDASM, backfinger.SLDPRT, backspacer.SLDPRT, baseplate.SLDPRT, baseplatejoined.SLDASM, baseplatejoined.sldprt, contact.SLDPRT]
2023-04-29 rcll:/gripper redesign updated STL of new iteration
    [assembled_positioningdisk.STL, backfinger.STL, baseplatejoined.STL, frontfinger.STL, positioningdisk.STL]
2023-05-10 rcll:/baseplate extrude updated; STL of new iteration
    [baseplate.SLDPRT, baseplatejoined.SLDASM, baseplatejoined.STL, baseplatejoined.sldprt]
2023-05-22 rcll-hardware: minor update to diameter of bore in baseplate
    [baseplate.SLDPRT, baseplatejoined.SLDASM, baseplatejoined.STL, baseplatejoined.sldprt]
2023-05-25 rcll: Hardware redesign for better printable gripper
    [baseplate.SLDPRT, baseplatejoined.SLDASM, baseplatejoined.STL, baseplatejoined.sldprt, supportprong.SLDPRT, supportprong.STL]
2023-06-02 rcll: resize motormount for bigger motor
    [Nema15.SLDPRT, baseplatejoined.sldprt, motormount.SLDPRT, motormount.STL]
2023-06-03 Added Solder_Pads Image
2023-06-20 rcll: realsense2_mount_iter1
    [base_rs2.SLDPRT, base_rs2.STL, mountflange_rs2.SLDPRT, mountflange_rs2.STL, sliderjoint_rs2.SLDPRT, sliderjoint_rs2.STL]
2023-06-20 rcll: mod_mount_flange_rs2
    [mountflange_rs2.SLDPRT, mountflange_rs2.STL]
2023-06-28 rcll: realsense ++ grip changes
    [baseplatejoined.STL, baseplatejoined.sldprt, endstopmount.SLDPRT, motormount.SLDPRT, motormount.STL, sliderjoint_rs2.SLDPRT, sliderjoint_rs2.STL]
2023-07-04 Hardware: update for gripper +realsense2
    [backfinger.SLDPRT, backfinger.STL, frontfinger.SLDPRT, frontfinger.STL, positioningdisk.SLDPRT, positioningdisk.STL, supportprong.SLDPRT, supportprong.STL]
2024-03-13 pictures: add photos of lasers
